simonmeaden/footprints/Harwell/lontott LOGIC BOARD.pdf

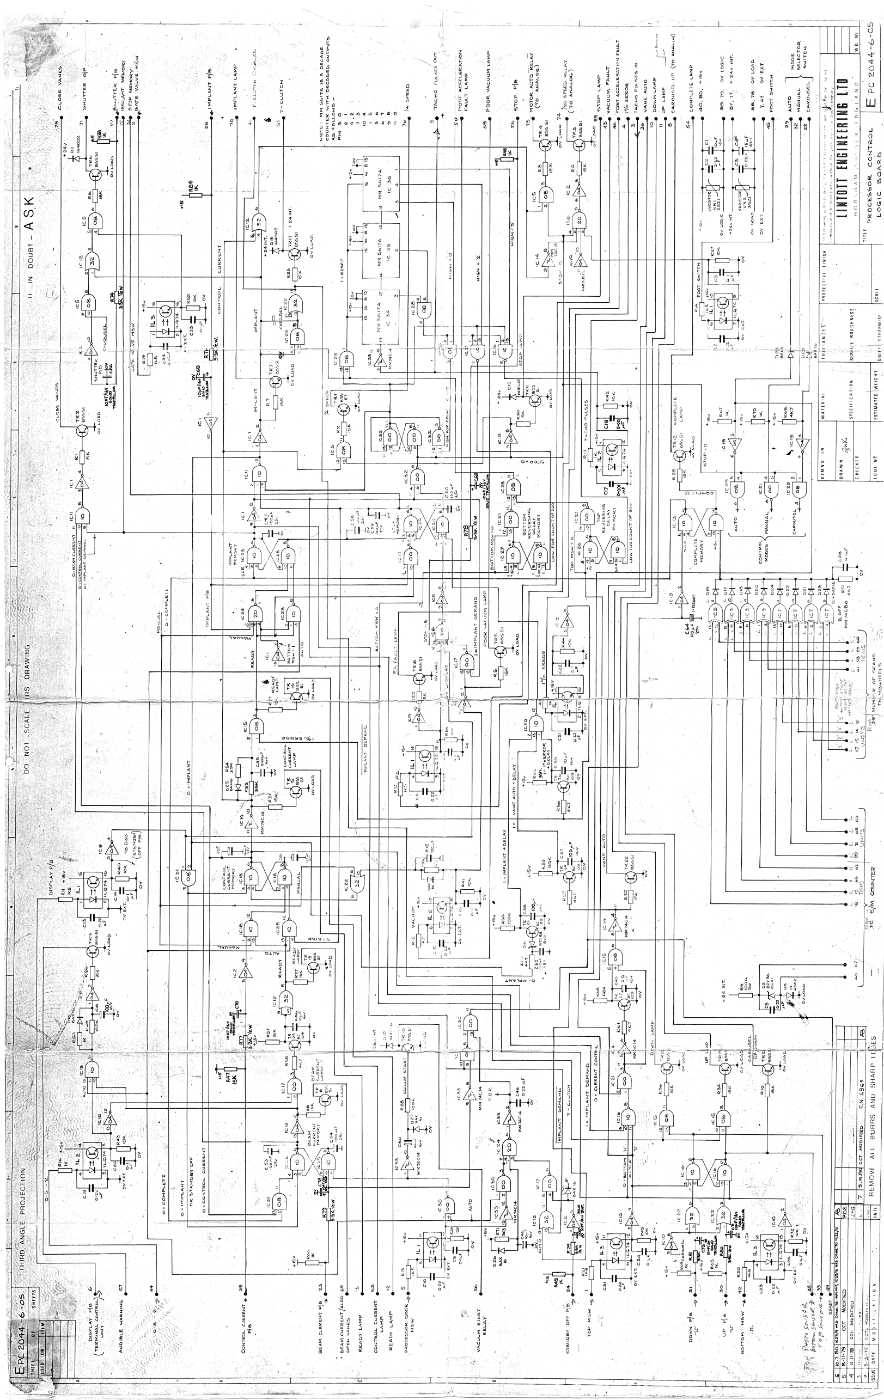
[picture p1: page 1]
