simonmeaden/footprints/Harwell/Remote control panel cables.PDF

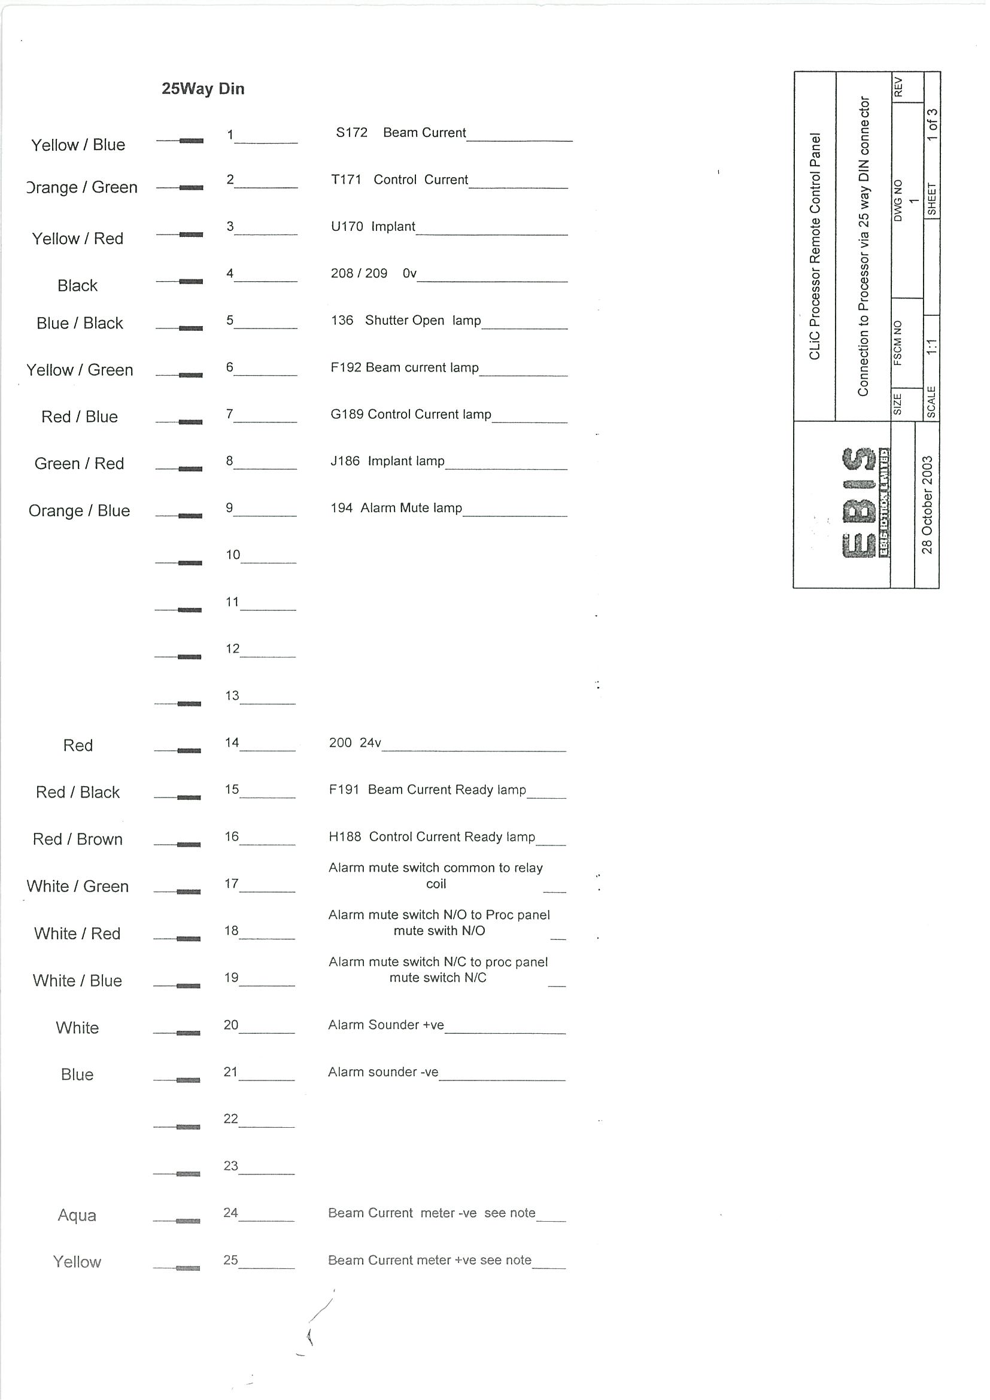
[picture p5: page 1]
