simonmeaden/footprints/Harwell/completeions.png

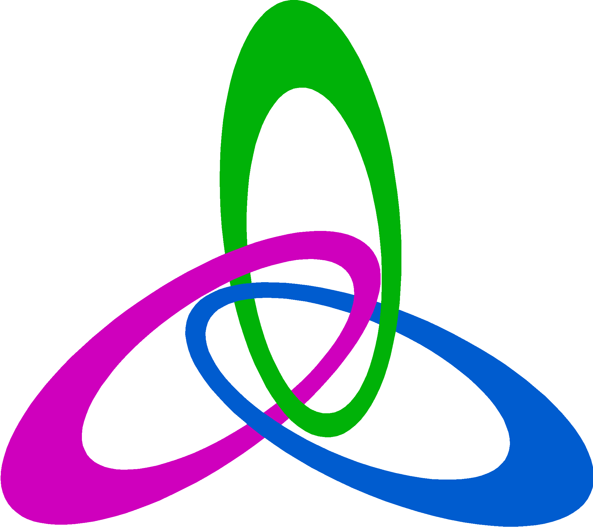
Harwell/completeions.png
