simonmeaden/footprints/Harwell/drawings/Analog_Board3.png

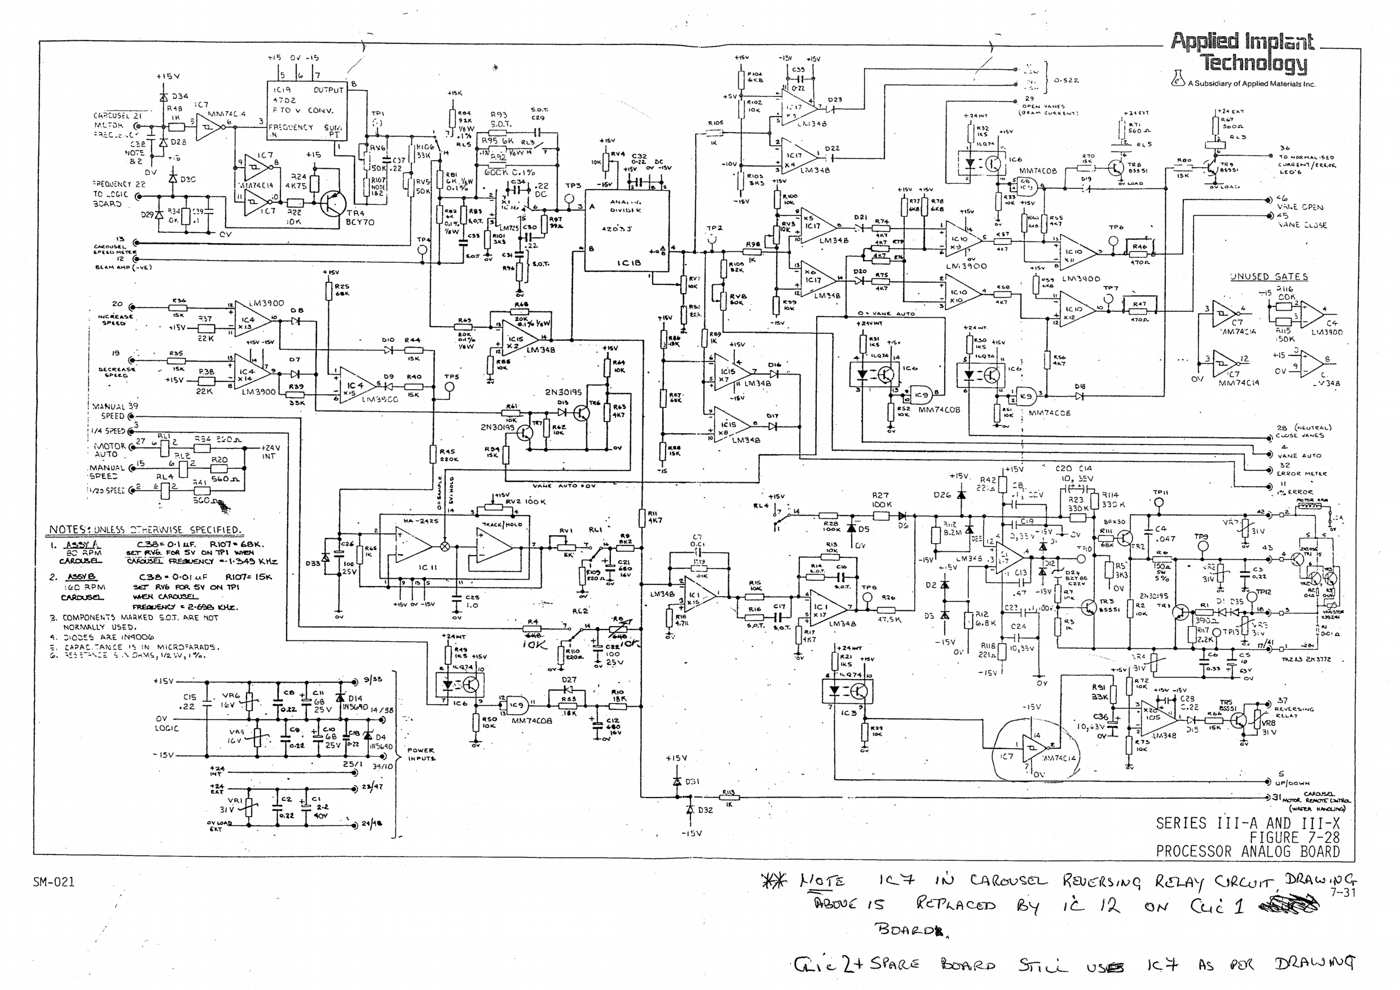
Harwell/drawings/Analog_Board3.png
