simonmeaden/footprints/Harwell/drawings/Clic Processor Remote Unit.png

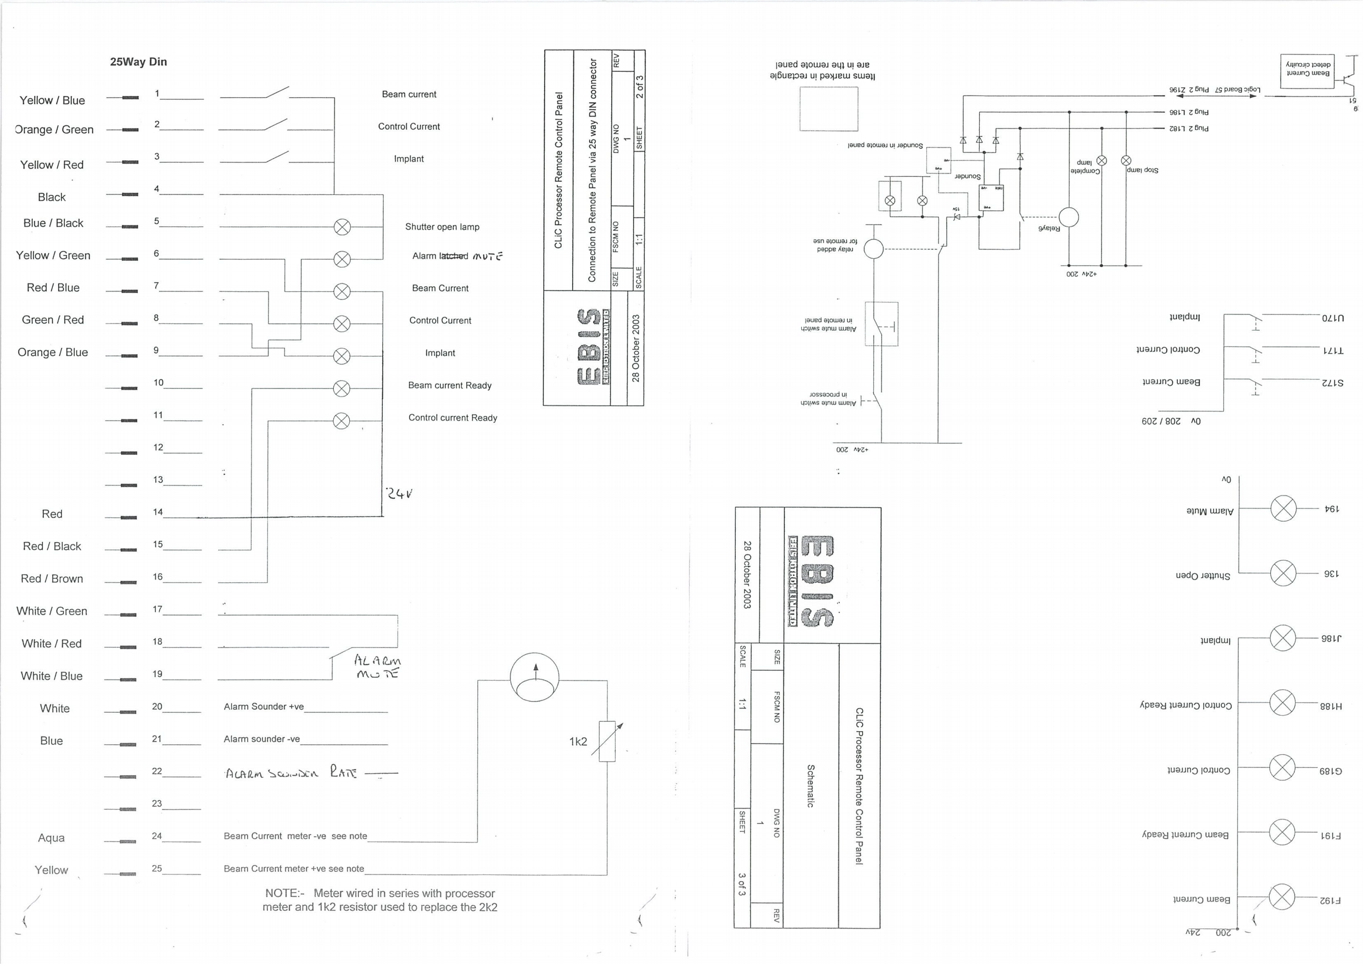
Harwell/drawings/Clic Processor Remote Unit.png
