simonmeaden/footprints/Harwell/drawings/Clutch Slip Detector.png

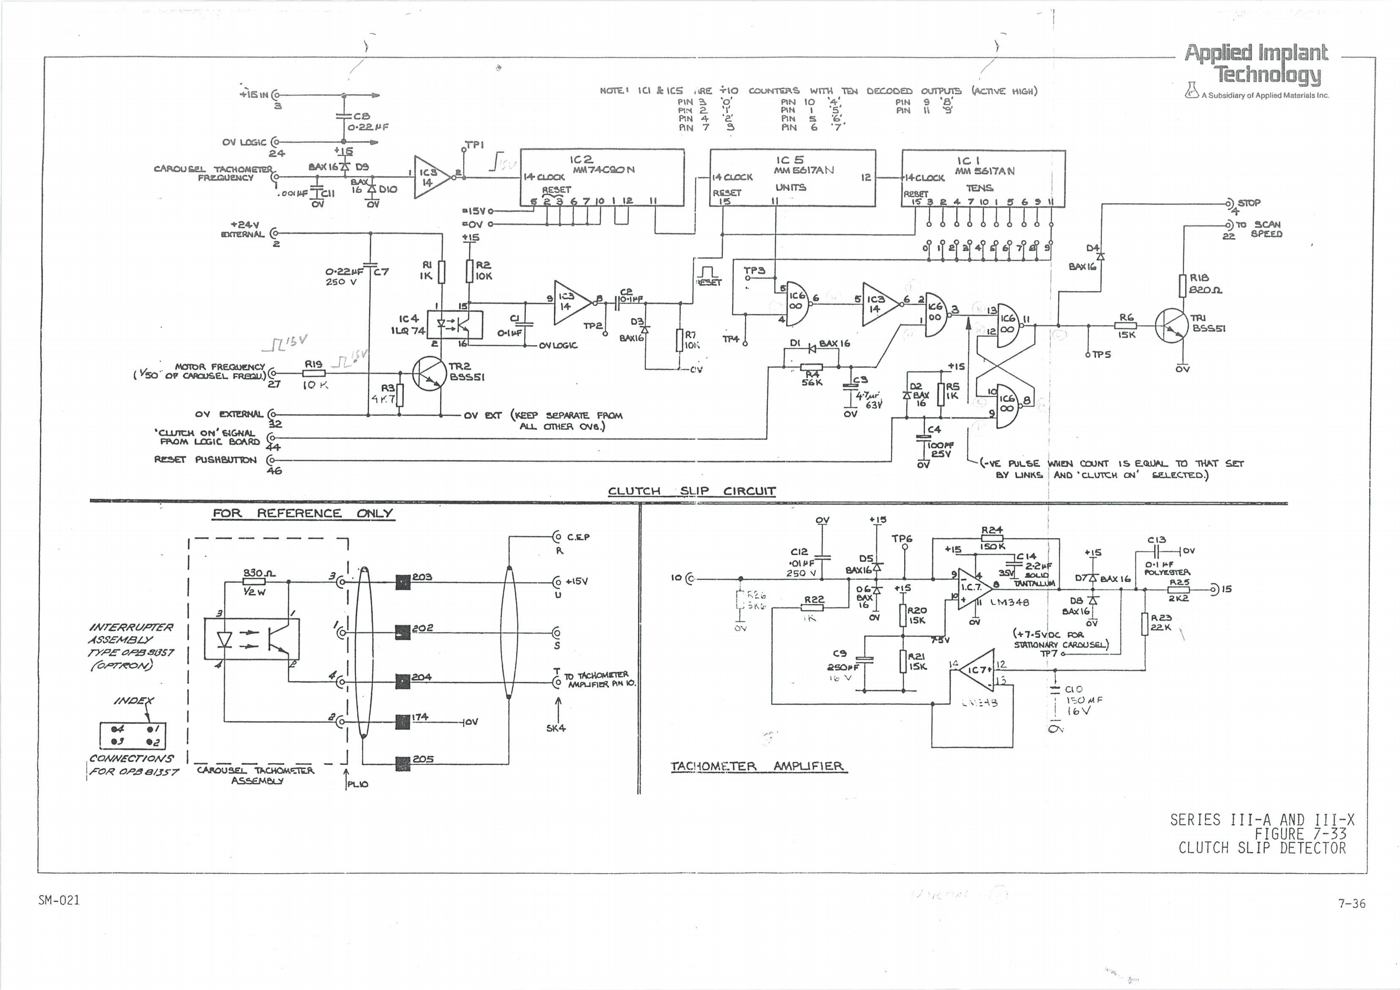
Harwell/drawings/Clutch Slip Detector.png
