simonmeaden/footprints/Harwell/drawings/Electromechanical Counter.png

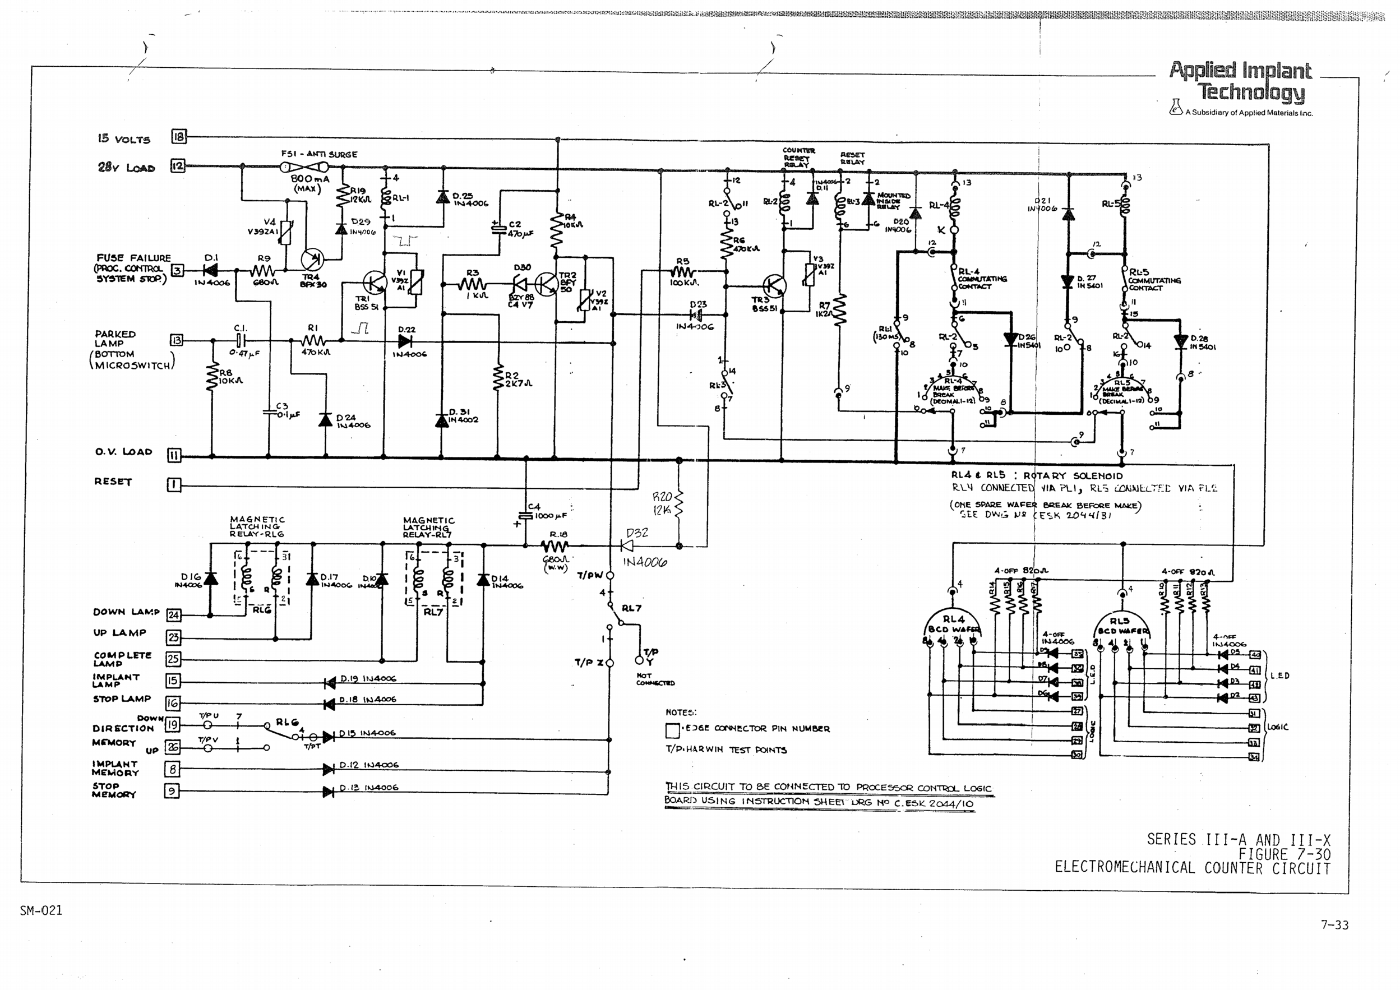
Harwell/drawings/Electromechanical Counter.png
