simonmeaden/footprints/Harwell/drawings/Left Right Drive Board.png

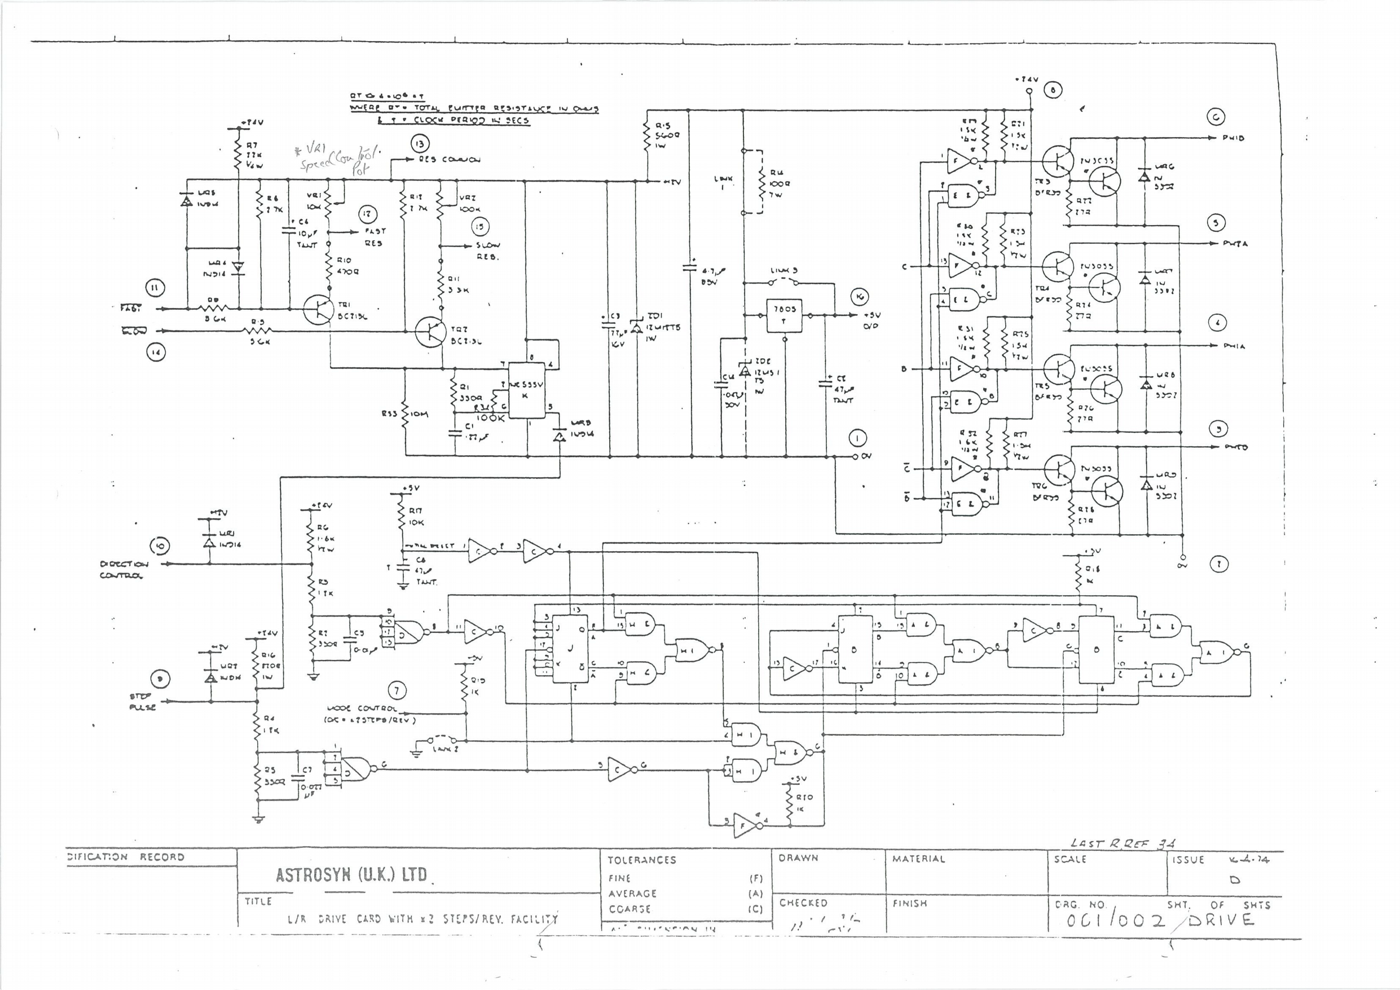
Harwell/drawings/Left Right Drive Board.png
