simonmeaden/footprints/Harwell/drawings/Outline.png

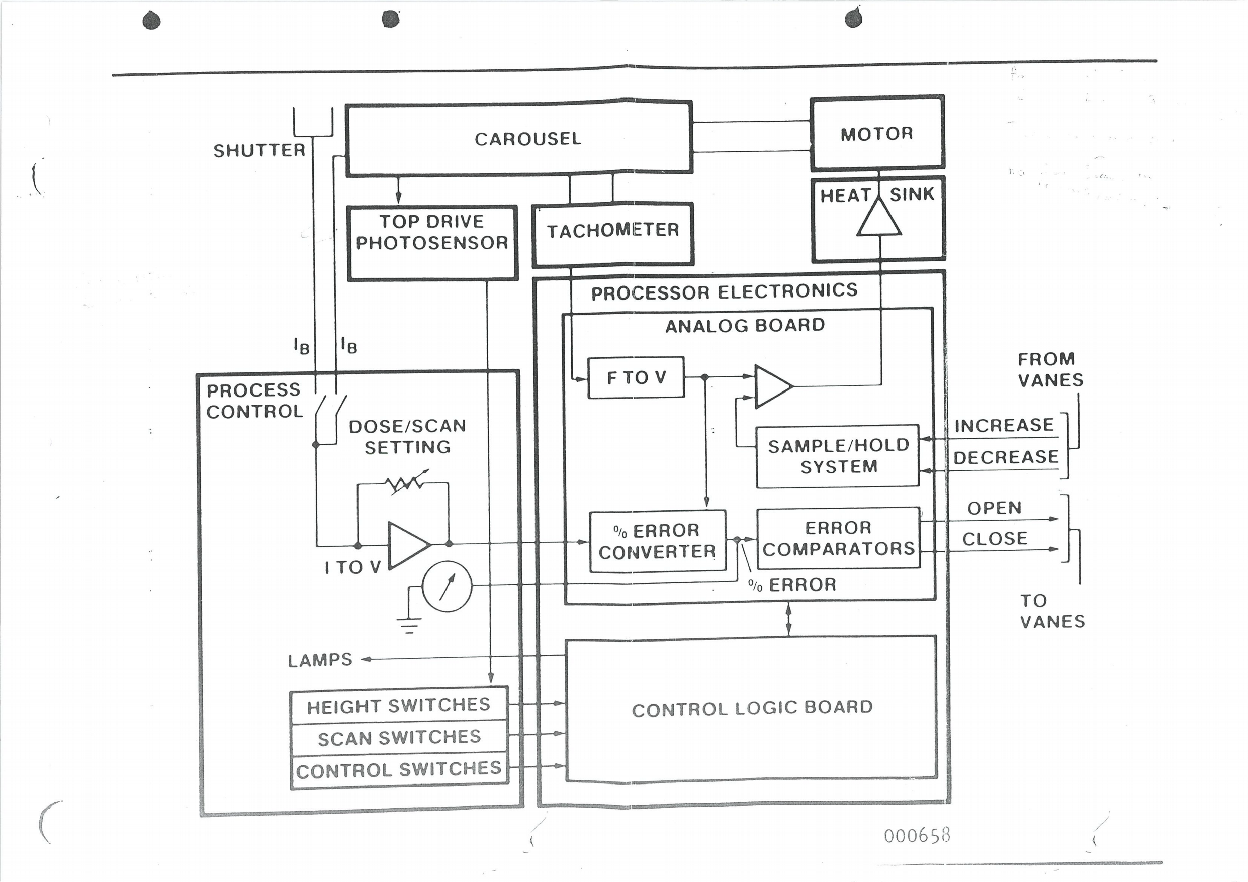
Harwell/drawings/Outline.png
