simonmeaden/footprints/Harwell/drawings/Processor Control Unit 1.png

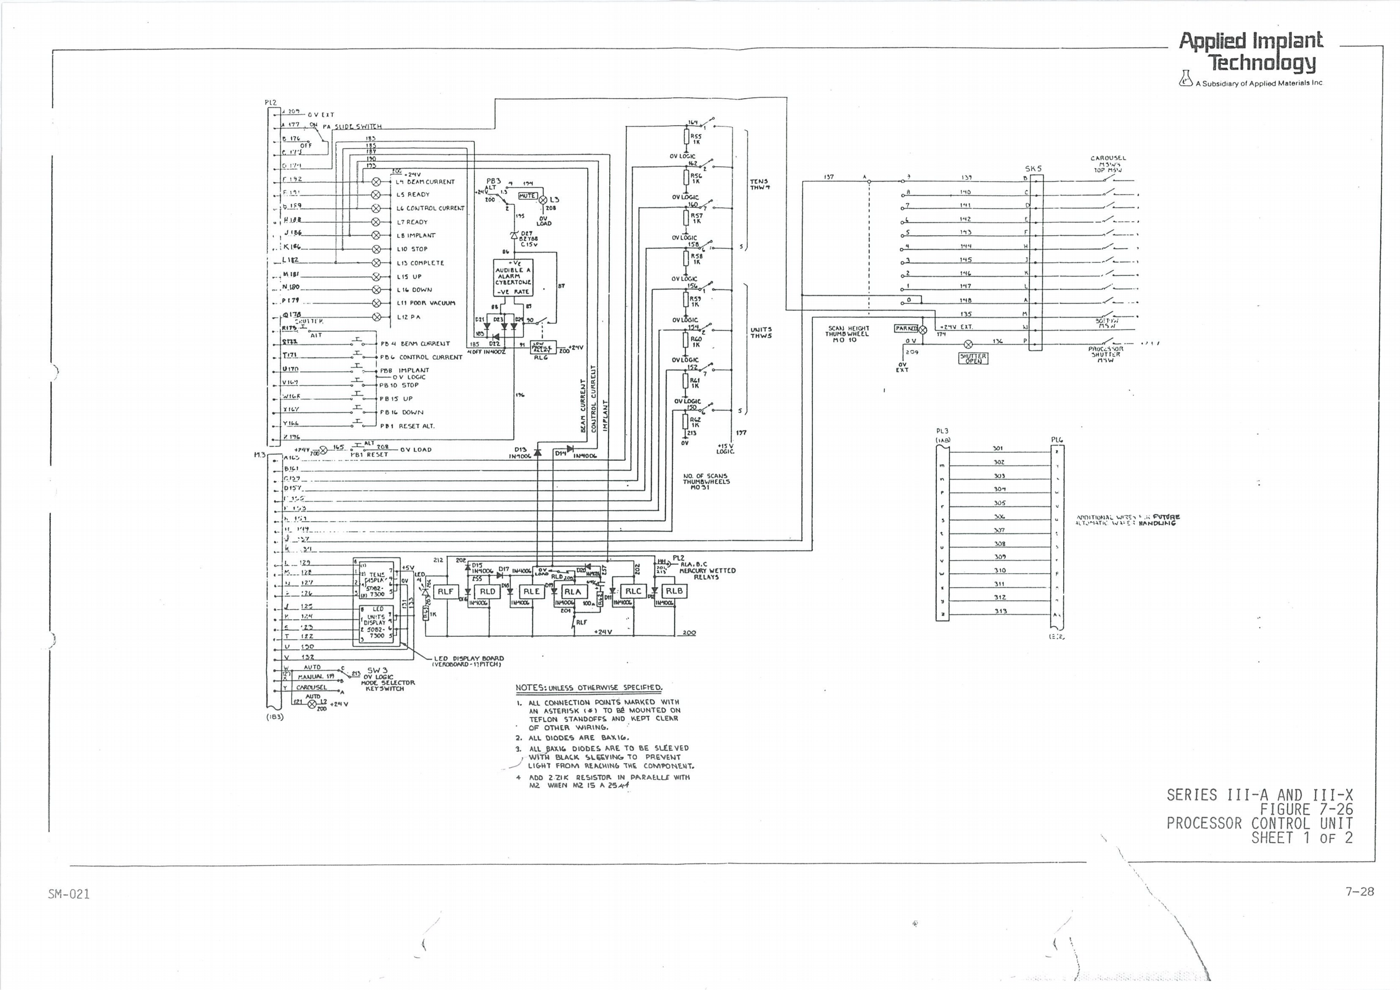
Harwell/drawings/Processor Control Unit 1.png
