simonmeaden/footprints/Harwell/drawings/Processor Control Unit 2.png

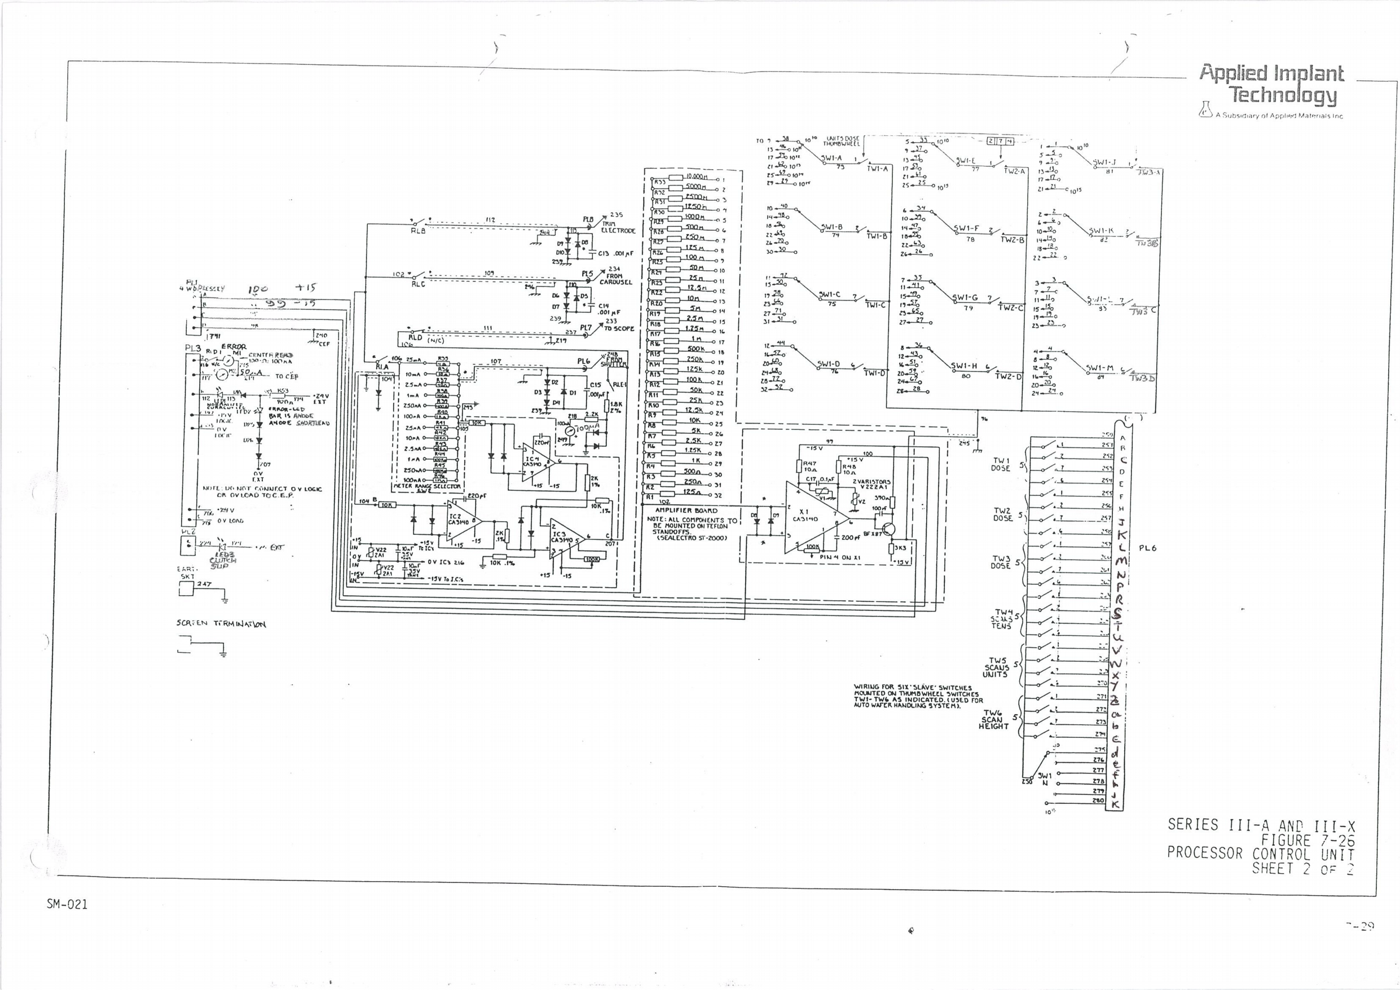
Harwell/drawings/Processor Control Unit 2.png
