simonmeaden/footprints/Harwell/drawings/Processor Control Unit 3.png

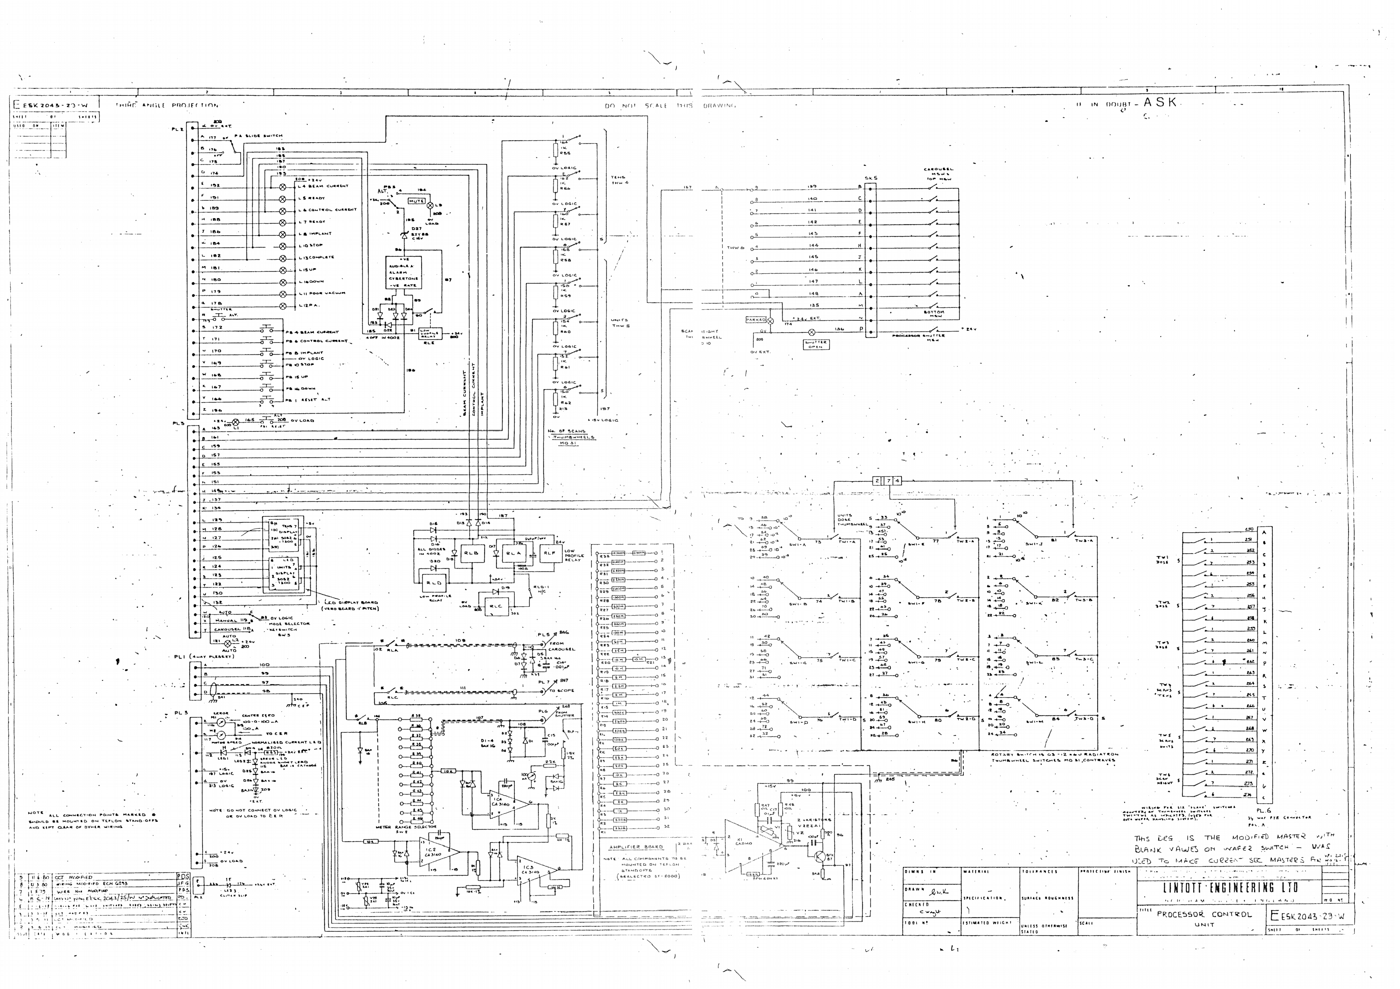
Harwell/drawings/Processor Control Unit 3.png
