simonmeaden/footprints/Harwell/drawings/Remote control panel cables.png

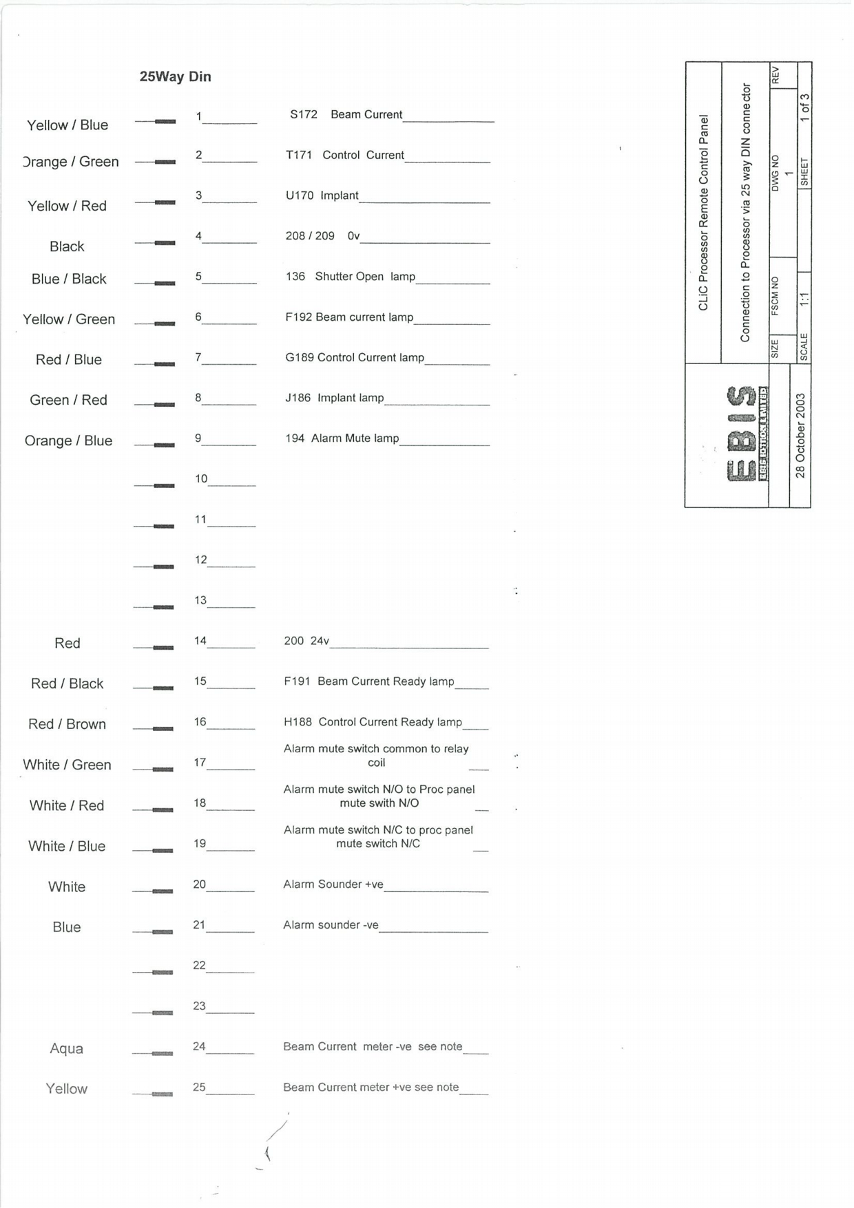
Harwell/drawings/Remote control panel cables.png
