simonmeaden/footprints/Harwell/drawings/Top Drive Phototsensor.png

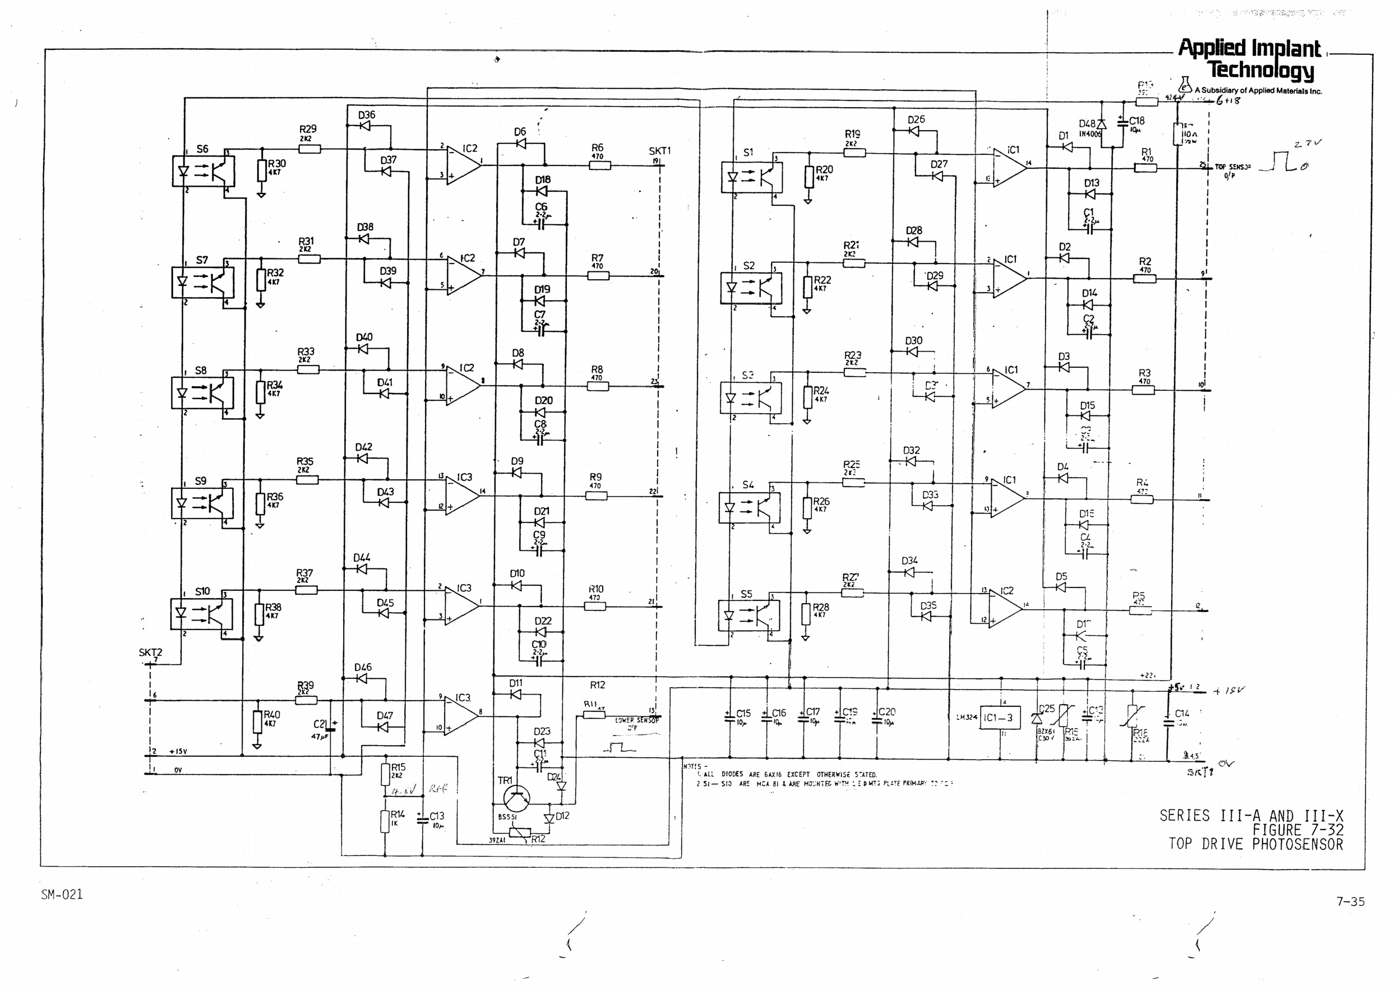
Harwell/drawings/Top Drive Phototsensor.png
