simonmeaden/footprints/Harwell/drawings/Vacuum Control.png

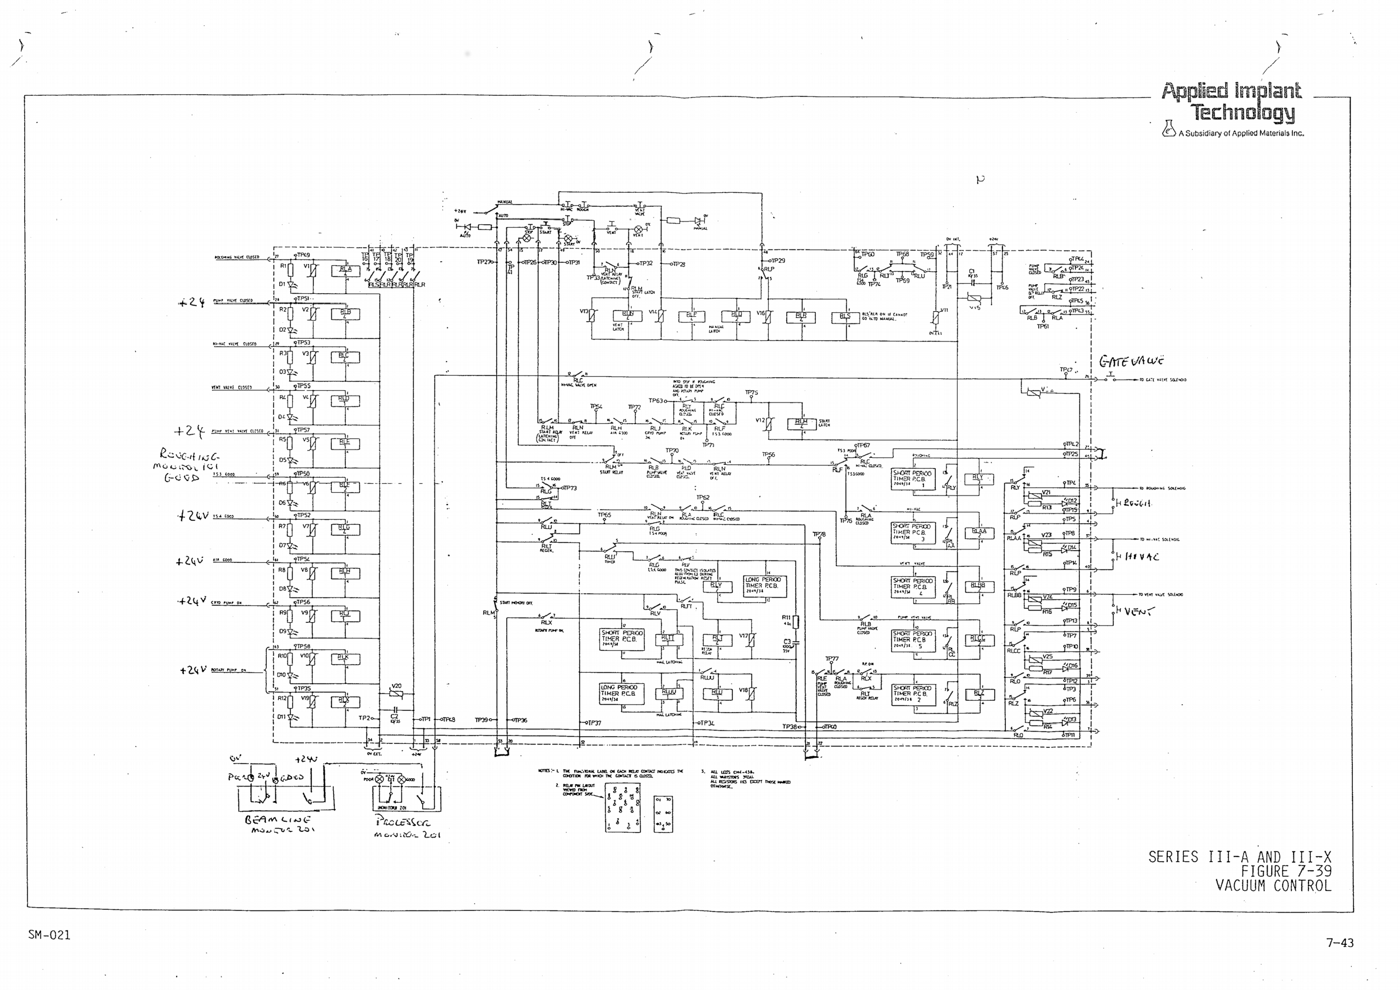
Harwell/drawings/Vacuum Control.png
