simonmeaden/footprints/Harwell/drawings/Vane Control Processor End.png

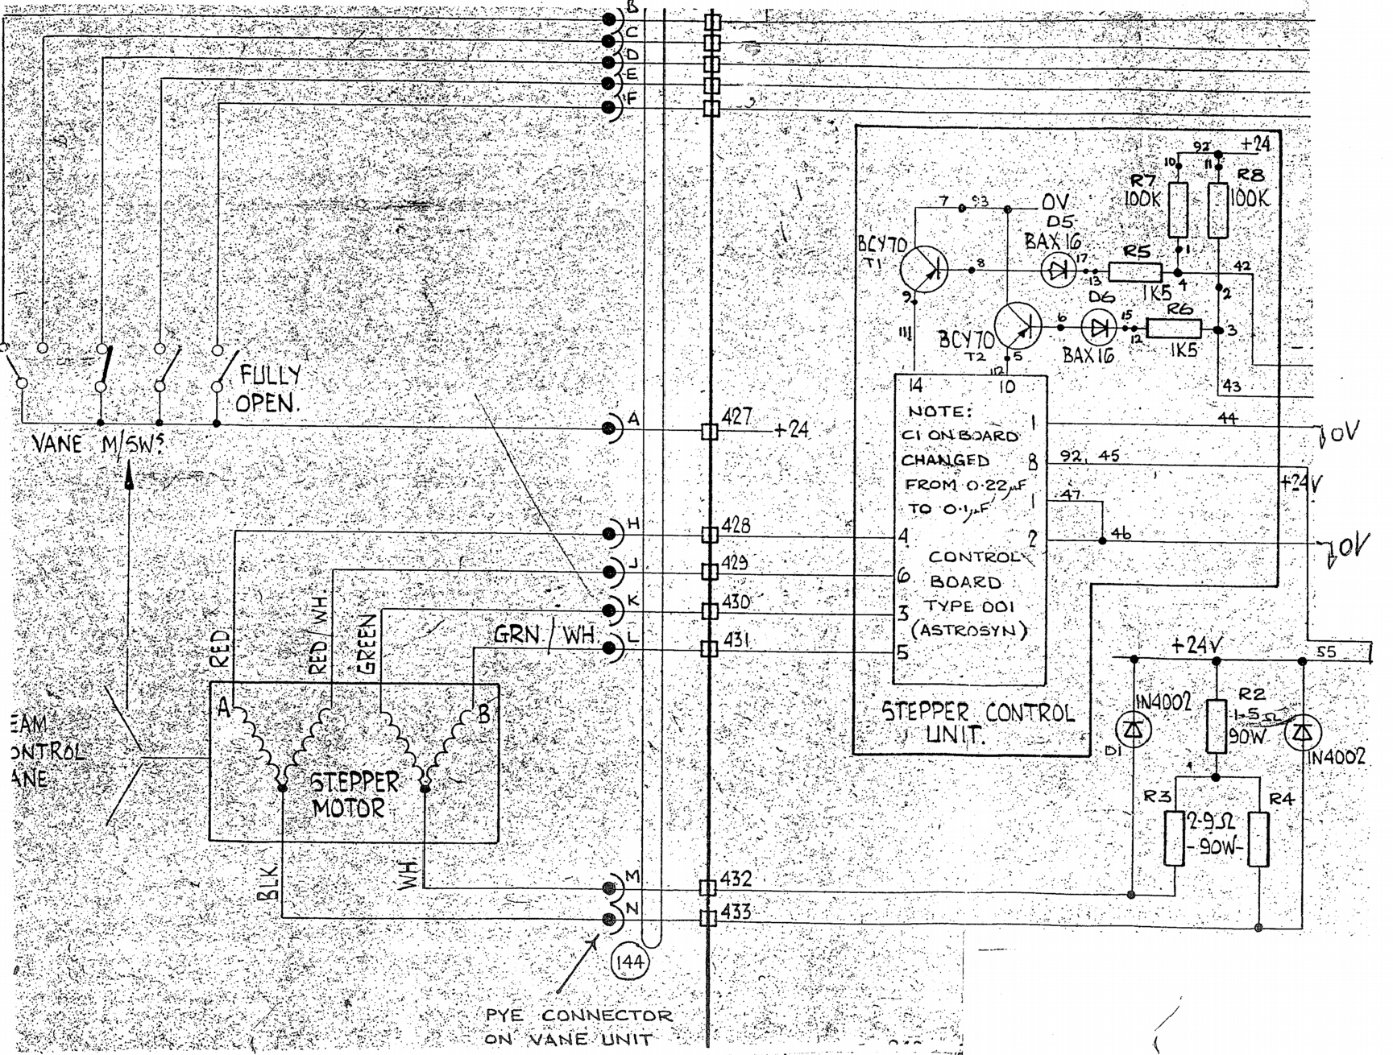
Harwell/drawings/Vane Control Processor End.png
