simonmeaden/footprints/Harwell/drawings/Vane Drive.png

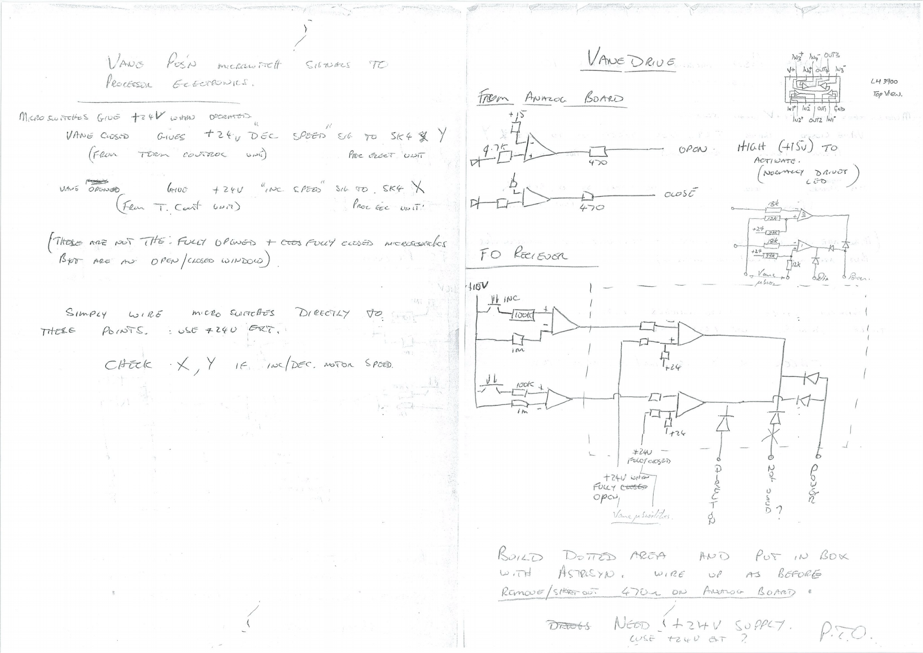
Harwell/drawings/Vane Drive.png
