simonmeaden/footprints/Harwell/drawings/Vane Stepper Unit.png

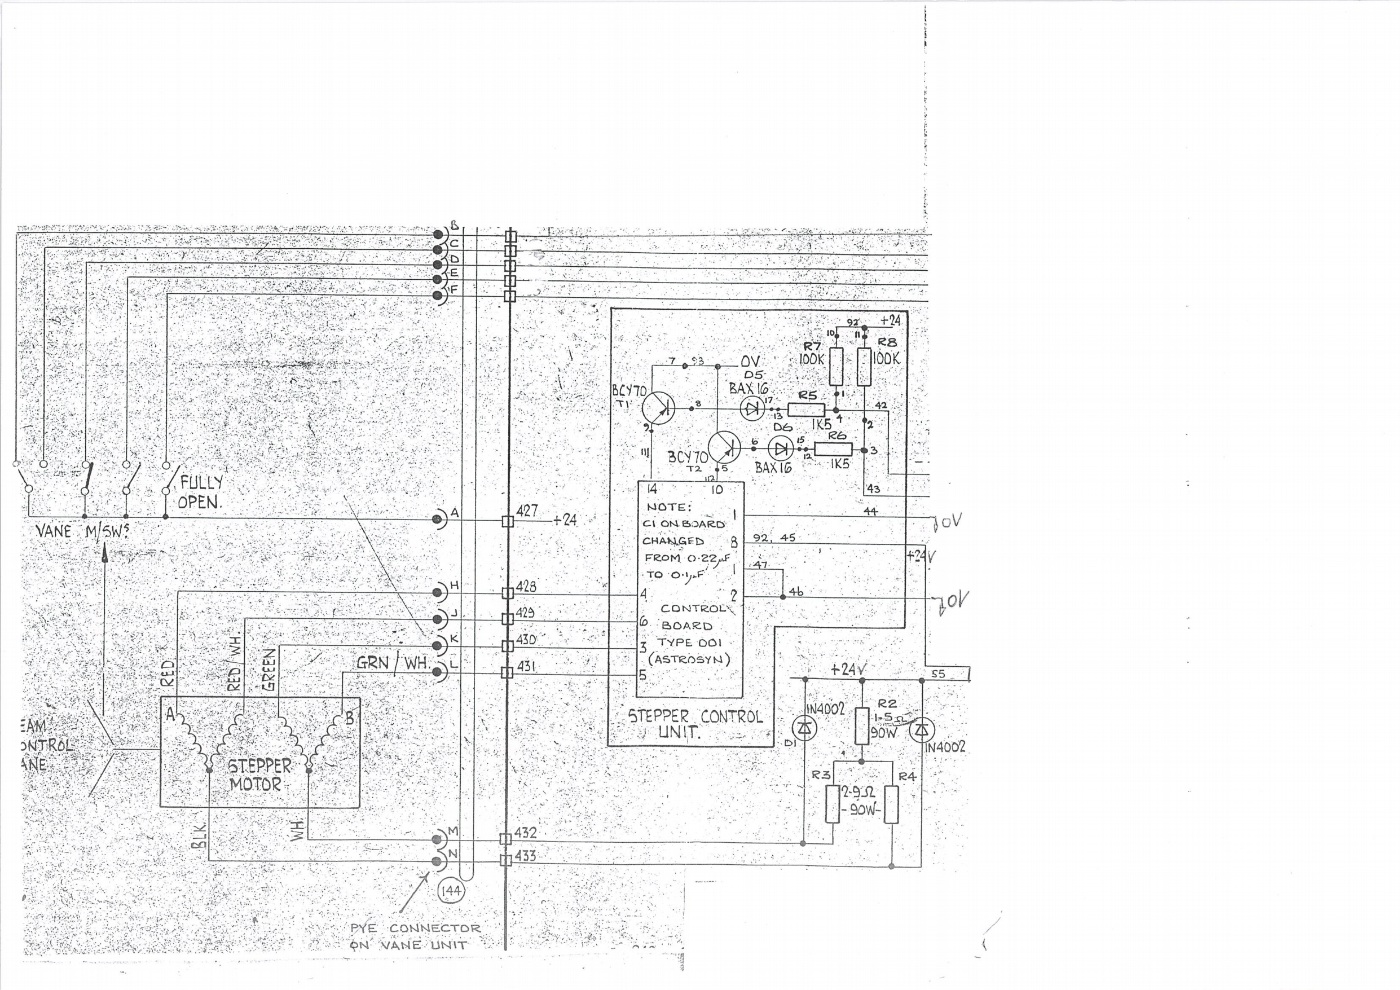
Harwell/drawings/Vane Stepper Unit.png
