simonmeaden/footprints/Harwell/parts.ods

Sheet: IC's
 |  | Part |  | Part
 | Manufacturer | Number | Supplier | Number | Description | Package
IC000001 | Microchip | SST25VF512 | Microchip | SST25VF512 | 512 Kbit SPI Serial Flash, 20MHz clock
IC000002 | Microchip | SST25VF512A | Microchip | SST25VF512A | 512 Kbit SPI Serial Flash, 33MHz clock
IC000003 | Microchip | MCP47FEB21 | Microchip | MCP47FEB21 | 12 Bit Single Channel DAC
IC000004 | Microchip | MCP47FEB22 | Microchip | MCP47FEB21 | 12 Bit Dual Channel DAC
IC000005 | Maxim | MAX743 | Farnell | 2514016 | Dual-Output Switch-Mode Regulator +5V to ±15V or ±12V
IC000006 | Intersil | CA3130 | Farnell | 1562025 | BiMOS Op Amp with MOSFET Input/ CMOS Output
IC000007 | On Semiconductor | CAT4139D | Mouser | 698-CAT4139TD-G | 22V PWM Modulated LED Driver
IC000008 | Solomon Systech | SSD1963 | In Stock | SSD1963 |  | LQFP128

Sheet: Transistors
Internal |  | Part |  | Part
Part Number | Manufacturer | Number | Supplier | Number
 |  |  | Farnell

Sheet: Diodes
Internal |  | Part |  | Part
Part Number | Manufacturer | Number | Supplier | Number
 |  |  | Farnell

Sheet: Capacitors
Internal |  | Part |  | Part
Part Number | Manufacturer | Number | Supplier | Number
 |  |  | Farnell

Sheet: Resistors
Internal |  | Part |  | Part
Part Number | Manufacturer | Number | Supplier | Number
 |  |  | Farnell

Sheet: Inductor
 |  | Part |  | Part
 | Manufacturer | Number | Supplier | Number | Description
L000001 | Wurth |  | RS Components |  | WE-TPC Series Type 3816 Shielded Wire-wound SMD Inductor with a Ferrite Core, 22 μH ±30% Wire-Wound 510mA Idc

Sheet: Connectors
 |  | Part |  | Part
 | Manufacturer | Number | Supplier | Number | Type | Pins | Polarity | Mounting | Shell | Series | Information
CON000001 | Amp-TE Connectivity | 5747250-4 | Farnell | 1653990 | D-Sub | 9 | Male | PCB | Metal Body | Amplimite HD-20
CON000002 | Cambdenboss | CTB0502/6 | Farnell | 2493624
CON000003 | Amphenol |  | Farnell
CON000004 | JST | SM02B-BHSS-1-TB(LF)(SN) | Farnell | 2399341 | Wire-to-board |  |  |  |  |  | Wire-To-Board Connector, 3.5 mm, 2 Contacts, Header, BHS
