simonmeaden/footprints/Harwell/PIC32MZ_Pin_Usage.ods

Pin | Description | Use
1 | AN23/RG15
2 | EBIA5/AN34/PMA5/RA5 | EBIA5 |  |  | Parallel Master Port || Extended Bus Interface
3 | EBID5/AN17/RPE5/PMD5/RE5 | EBID5 |  |  | Parallel Master Port || Extended Bus Interface
4 | EBID6/AN16/PMD6/RE6 | EDID6 |  |  | Parallel Master Port || Extended Bus Interface
5 | EBID7/AN15/PMD7/RE7 | EPID7 |  |  | Parallel Master Port || Extended Bus Interface
6 | EBIA6/AN22/RPC1/PMA6/RC1 | EBIA6 |  |  | Parallel Master Port || Extended Bus Interface
7 | AN35/ETXD0/RJ8
8 | AN36/ETXD1/RJ9
9 | EBIBS0/RJ12 | EBIBS0 |  |  | Parallel Master Port || Extended Bus Interface
10 | EBIBS1/RJ10 | EBIBS1 |  |  | Parallel Master Port || Extended Bus Interface
11 | EBIA12/AN21/RPC2/PMA12/RC2 | EBIA12 |  |  | Parallel Master Port || Extended Bus Interface
12 | EBIWE/AN20/RPC3/PMWR/RC3 | EBIWE |  |  | Parallel Master Port || Extended Bus Interface
13 | EBIOE/AN19/RPC4/PMRD/RC4 | EBIOE |  |  | Parallel Master Port || Extended Bus Interface
14 | AN14/C1IND/RPG6/SCK2/RG6 | RS232-RTS | RPG6 | U1RTS | RS232
15 | AN13/C1INC/RPG7/SDA4/RG7 | RS232-TX | RPG7 | U1TX | RS232
16 | AN12/C2IND/RPG8/SCL4/RG8 | RS232-RX | RPG8 | U1RX | RS232
17 | VSS | VSS |  |  | Power
18 | VDD | VDD |  |  | Power
19 | EBIA16/RK0 | EBIA16 |  |  | Parallel Master Port || Extended Bus Interface
20 | MCLR | MCLR |  |  | Reset
21 | EBIA2/AN11/C2INC/RPG9/PMA2/RG9 | EBIA2 |  |  | Parallel Master Port || Extended Bus Interface
22 | TMS/AN24/RA0
23 | AN25/RPE8/RE8 | RS232-CTS | RPG9 | U1CTS | RS232
24 | AN26/RPE9/RE9
25 | AN45/C1INA/RPB5/RB5
26 | AN4/C1INB/RB4 | AN4 |  |  | Dedicated Analogue In
27 | AN37/ERXCLK/EREFCLK/RJ11
28 | EBIA13/PMA13/RJ13 | EBIA13 |  |  | Parallel Master Port || Extended Bus Interface
29 | EBIA11/PMA11/RJ14 | EBIA11 |  |  | Parallel Master Port || Extended Bus Interface
30 | EBIA0/PMA0/RJ15 | EBIA0 |  |  | Parallel Master Port || Extended Bus Interface
31 | AN3/C2INA/RPB3/RB3 | AN3 |  |  | Dedicated Analogue In
32 | VSS |  |  |  | Power
33 | VDD |  |  |  | Power
34 | AN2/C2INB/RPB2/RB2 | AN2 |  |  | Dedicated Analogue In
35 | PGEC1/AN1/RPB1/RB1 | AN1 |  |  | Dedicated Analogue In
36 | PGED1/AN0/RPB0/RB0 | AN0 |  |  | Dedicated Analogue In
37 | PGEC2/AN46/RPB6/RB6 | PGEC2 | ICSP |  | Device Programming Interface
38 | PGED2/AN47/RPB7/RB7 | PGED2 | ICSP |  | Device Programming Interface
39 | VREF-/CVREF-/AN27/RA9
40 | VREF+/CV REF+/AN28/RA10
41 | AVDD | AVDD |  |  | Power
42 | AVSS | AVSS
43 | AN38/ETXD2/RH0 | EXT-0-INTB |  |  | External Bus Extender Interrupt
44 | AN39/ETXD3/RH1 | EXT-0-INTA |  |  | External Bus Extender Interrupt
45 | EBIRP/RH2 | EBIRP |  |  | Parallel Master Port || Extended Bus Interface
46 | RH3 | EXT-1-INTA |  |  | External Bus Extender Interrupt
47 | EBIA10/AN48/RPB8/PMA10/RBEBIA7/AN49/RPB9/PMA7/RB9 | EBIA10 |  |  | Parallel Master Port || Extended Bus Interface
48 | EBIA7/AN49/RPB9/PMA7/RB9 | EBIA7 |  |  | Parallel Master Port || Extended Bus Interface
49 | CV REFOUT/AN5/RPB10/RB10 | AN5
50 | AN6/RB11 | AN6
51 | EBIA1/PMA1/RK1 | EBIA1 |  |  | Parallel Master Port || Extended Bus Interface
52 | EBIA3/PMA3/RK2 | EBIA3 |  |  | Parallel Master Port || Extended Bus Interface
53 | EBIA17/RK3 | EBIA17 |  |  | Extended Bus Interface
54 | VSS | VSS
55 | VDD | VDD
56 | TCK/AN29/RA1 | EXT-1-INTB |  |  | External Bus Extender Interrupt
57 | TDI/AN30/RPF13/SCK5/RF13
58 | TDO/AN31/RPF12/RF12
59 | AN7/RB12 | AN7
60 | AN8/RB13 | EXT-2-INTA |  |  | External Bus Extender Interrupt
61 | AN9/RPB14/SCK3/RB14 | 485TX | RPB14 | U2TX | RS485
62 | AN10/RPB15/OCFB/RB15 | 485RX | RPB15 | U2RX | RS485
63 | VSS | VSS
64 | VDD | VDD
65 | AN40/ERXERR/RH4 | EXT-3-INTB |  |  | External Bus Extender Interrupt
66 | AN41/ERXD1/RH5 | EXT-3-INTA |  |  | External Bus Extender Interrupt
67 | AN42/ERXD2/RH6 | EXT-2-INTB |  |  | External Bus Extender Interrupt
68 | EBIA4/PMA4/RH7 | EBIA4 |  |  | Parallel Master Port || Extended Bus Interface
69 | AN32/RPD14/RD14 | EXT-4-INTB |  |  | External Bus Extender Interrupt
70 | AN33/RPD15/SCK6/RD15 | EXT-4-INTA |  |  | External Bus Extender Interrupt
71 | OSC1/CLKI/RC12
72 | OSC2/CLKO/RC15
73 | V BUS | VBUS
74 | VUSB3V3 | VUSB3V3
75 | VSS | VSS
76 | D- | D- |  |  | USB
77 | D+ | D+ |  |  | USB
78 | RPF3/USBID/RF3
79 | SDA3/RPF2/RF2
80 | SCL3/RPF8/RF8
81 | ERXD0/RH8
82 | ERXD3/RH9
83 | ECOL/RH10
84 | EBIRDY2/RH11 | EBIRDY2 |  |  | Parallel Master Port || Extended Bus Interface
85 | SCL2/RA2
86 | EBIRDY1/SDA2/RA3 | EBIRDY1 |  |  | Parallel Master Port || Extended Bus Interface
87 | EBIA14/PMCS1/PMA14/RA4 | EBIA14 |  |  | Parallel Master Port || Extended Bus Interface
88 | VDD | VDD
89 | VSS | VSS
90 | EBIA9/RPF4/SDA5/PMA9/RF4 | EBIA9 |  |  | Parallel Master Port || Extended Bus Interface
91 | EBIA8/RPF5/SCL5/PMA8/RF5 | EBIA8 |  |  | Parallel Master Port || Extended Bus Interface
92 | EBIA18/RK4 | EBIA18 |  |  | Extended Bus Interface
93 | EBIA19/RK5 | EBIA19 |  |  | Extended Bus Interface
94 | EBIA20/RK6 | EBIA20 |  |  | Extended Bus Interface
95 | RPA14/SCL1/RA14
96 | RPA15/SDA1/RA15
97 | EBIA15/RPD9/PMCS2/PMA15/RD9 | EBIA15 |  |  | Parallel Master Port || Extended Bus Interface
98 | RPD10/SCK4/RD10 | C1TX | RPD10 | CAN TX | CAN
99 | EMDC/RPD11/RD11 | C1RX | RPD11 | CAN RX | CAN
100 | ECRS/RH12
101 | ERXDV/ECRSDV/RH13
102 | RH14
103 | EBIA23/RH15 | EBIA23 |  |  | Extended Bus Interface
104 | RPD0/RTCC/INT0/RD0
105 | SOSCI/RPC13/RC13
106 | SOSCO/RPC14/T1CK/RC14
107 | VDD | VDD
108 | VSS | VSS
109 | RPD1/SCK1/RD1 | SCK1 |  | SPI
110 | EBID14/RPD2/PMD14/RD2 | EBID14 |  |  | Parallel Master Port || Extended Bus Interface
111 | EBID15/RPD3/PMD15/RD3 | EBID15 |  |  | Parallel Master Port || Extended Bus Interface
112 | EBID12/RPD12/PMD12/RD12 | EBID12 |  |  | Parallel Master Port || Extended Bus Interface
113 | EBID13/PMD13/RD13 | EBID13 |  |  | Parallel Master Port || Extended Bus Interface
114 | ETXERR/RJ0
115 | EMDIO/RJ1
116 | EBIRDY3/RJ2 | EBIRDY3 |  |  | Parallel Master Port || Extended Bus Interface
117 | EBIA22/RJ3 | EBIA22 |  |  | Extended Bus Interface
118 | SQICS0/RPD4/RD4 | SS1 | RPD4 | SPI | SPI
119 | SQICS1/RPD5/RD5
120 | ETXEN/RPD6/RD6 | SDI1 | RPD6 | SPI | SPI
121 | ETXCLK/RPD7/RD7 | SDO1 | RPD7 | SPI | SPI
122 | VDD | VDD
123 | VSS | VSS
124 | EBID11/RPF0/PMD11/RF0 | EBID11 |  |  | Parallel Master Port || Extended Bus Interface
125 | EBID10/RPF1/PMD10/RF1 | EBID10 |  |  | Parallel Master Port || Extended Bus Interface
126 | EBIA21/RK7 | EBIA21 |  |  | Extended Bus Interface
127 | EBID9/RPG1/PMD9/RG1 | EBID9 |  |  | Parallel Master Port || Extended Bus Interface
128 | EBID8/RPG0/PMD8/RG0 | EBID8 |  |  | Parallel Master Port || Extended Bus Interface
129 | TRCLK/SQICLK/RA6
130 | TRD3/SQID3/RA7
131 | EBICS0/RJ4 | EBICS0 |  |  | Parallel Master Port || Extended Bus Interface
132 | EBICS1/RJ5 | EBICS1 |  |  | Parallel Master Port || Extended Bus Interface
133 | EBICS2/RJ6 | EBICS2 |  |  | Parallel Master Port || Extended Bus Interface
134 | EBICS3/RJ7 | EBICS3 |  |  | Parallel Master Port || Extended Bus Interface
135 | EBID0/PMD0/RE0 | EBID0 |  |  | Parallel Master Port || Extended Bus Interface
136 | VSS | VSS
137 | VDD | VDD
138 | EBID1/PMD1/RE1 | EBID10 |  |  | Parallel Master Port || Extended Bus Interface
139 | TRD2/SQID2/RG14
140 | TRD1/SQID1/RG12
141 | TRD0/SQID0/RG13
142 | EBID2/PMD2/RE2 | EBID2 |  |  | Parallel Master Port || Extended Bus Interface
143 | EBID3/RPE3/PMD3/RE3 | EBID3 |  |  | Parallel Master Port || Extended Bus Interface
144 | EBID4/AN18/PMD4/RE4 | EBID4 |  |  | Parallel Master Port || Extended Bus Interface
