simonmeaden/footprints/Harwell/drawings/Base Frame Wiring.png

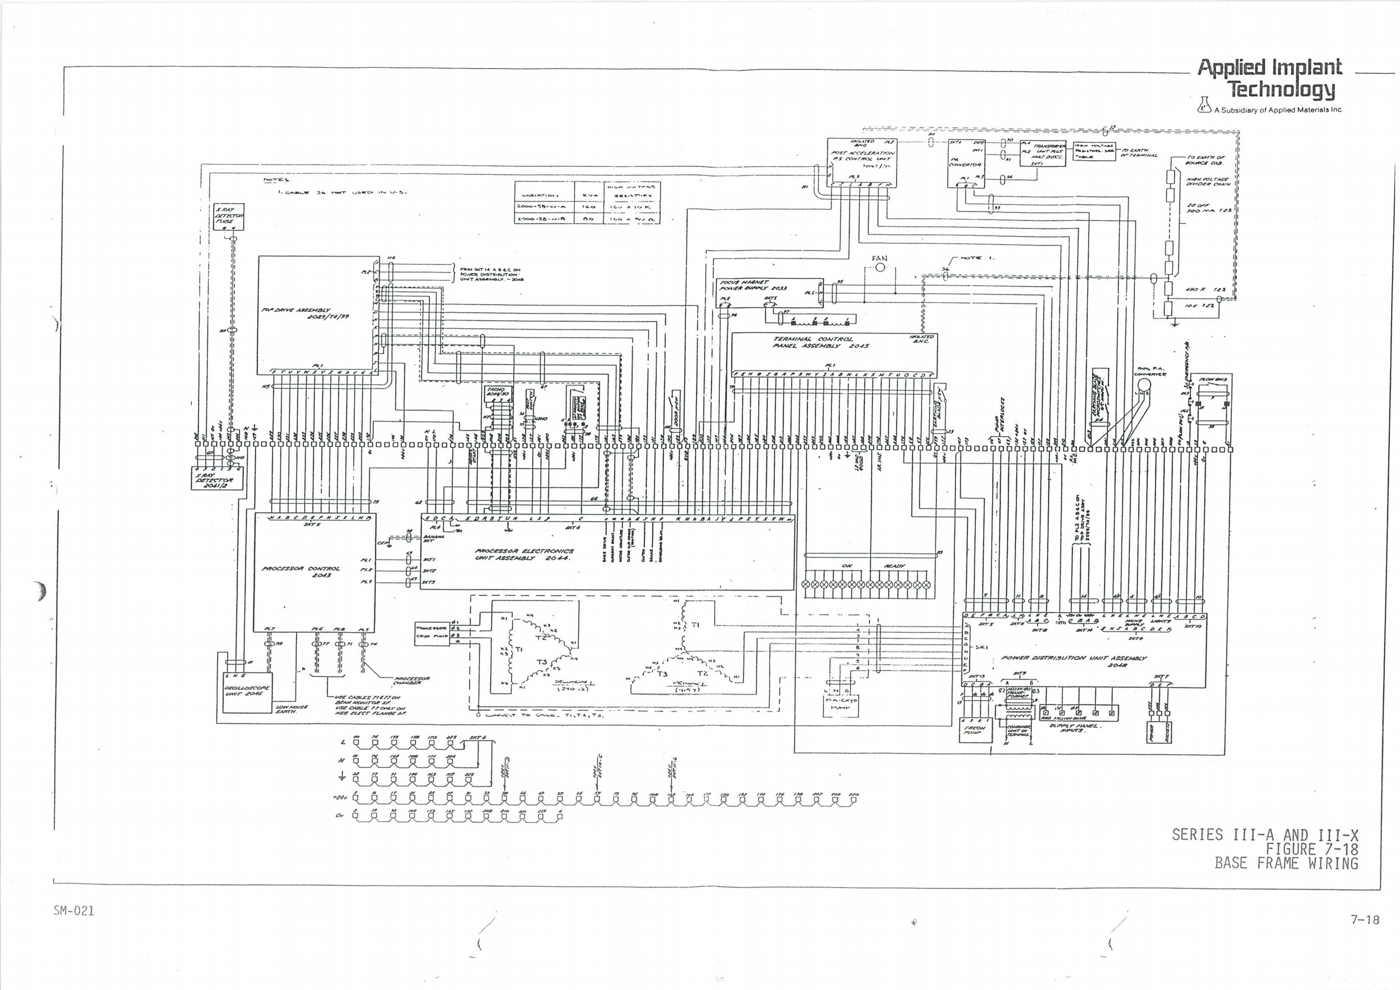
Harwell/drawings/Base Frame Wiring.png
