simonmeaden/footprints/Harwell/drawings/Processor Electronic Unit Wiring.png

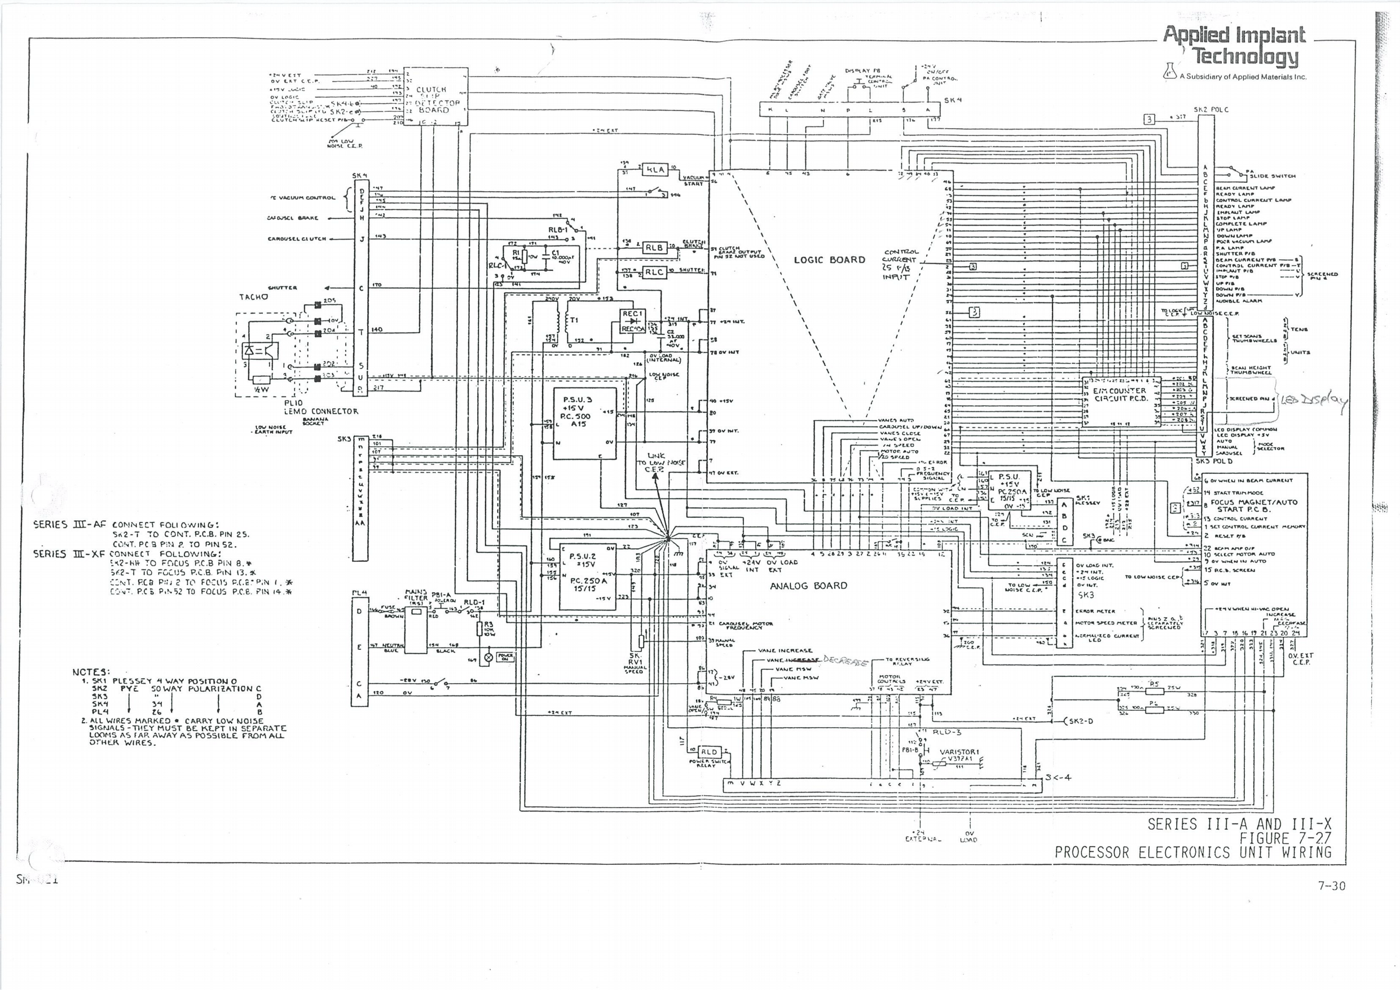
Harwell/drawings/Processor Electronic Unit Wiring.png
