simonmeaden/footprints/Harwell/drawings/Processor Top Drive Wiring.png

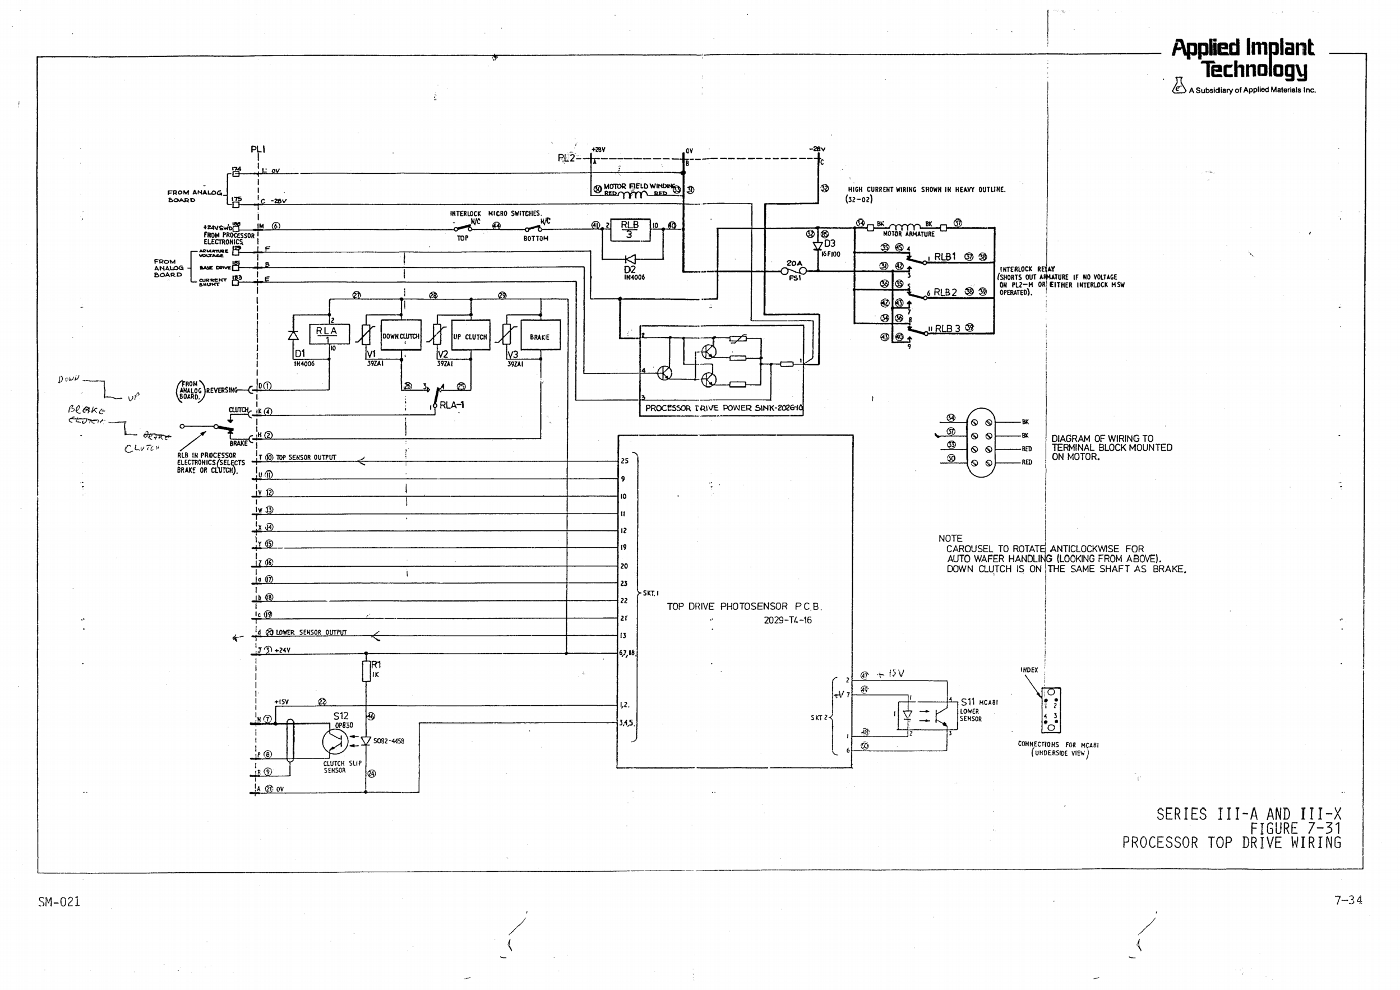
Harwell/drawings/Processor Top Drive Wiring.png
