simonmeaden/footprints/Harwell/drawings/Vacuum Control Wiring.png

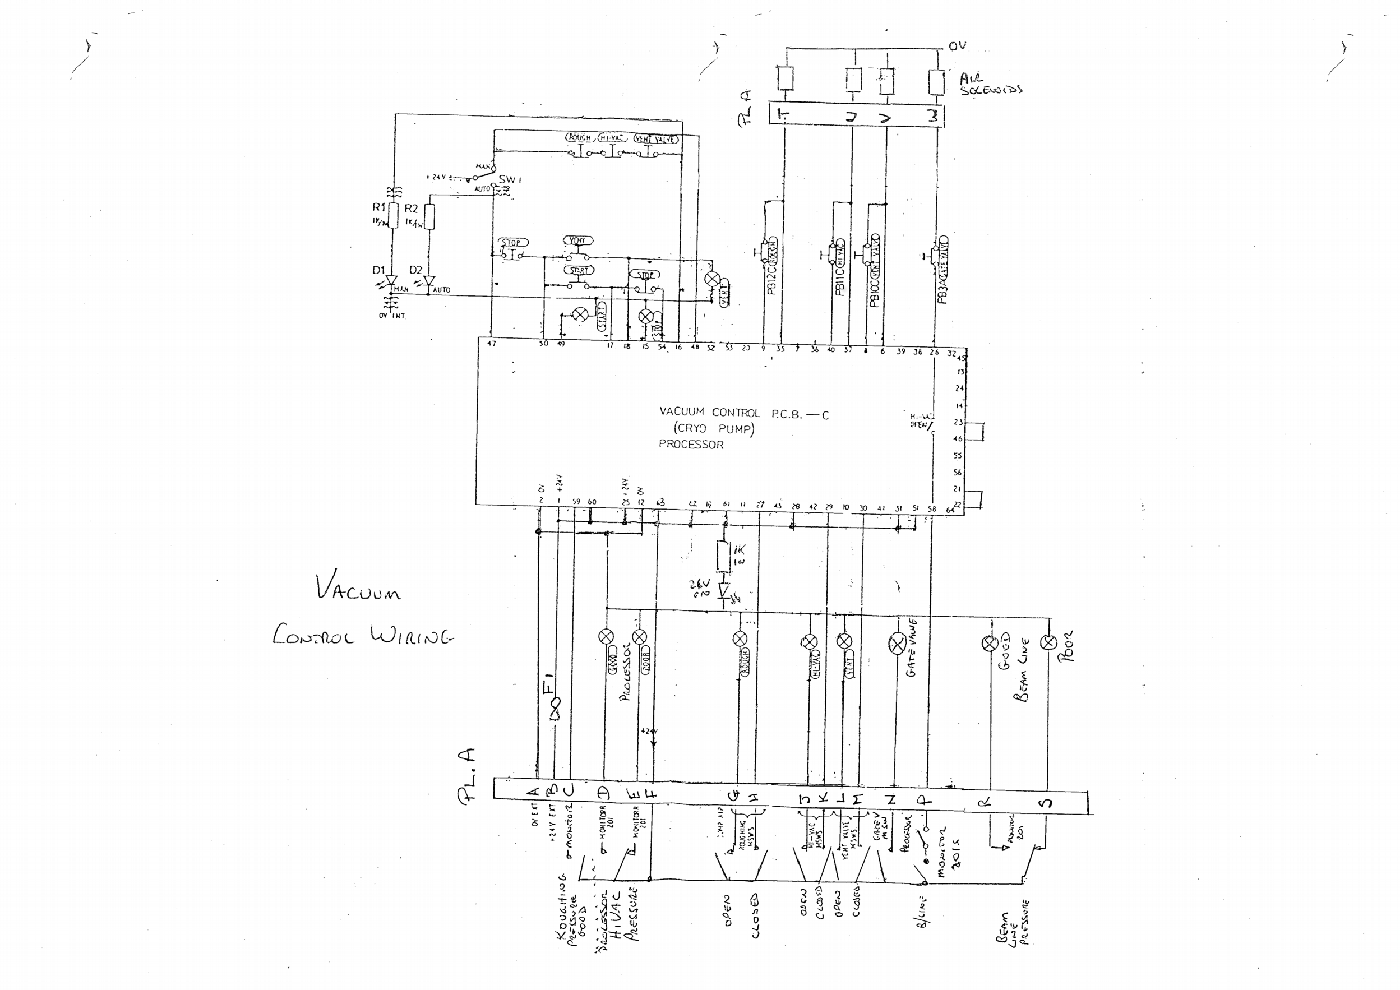
Harwell/drawings/Vacuum Control Wiring.png
