simonmeaden/footprints/Harwell/schematics/pcu/psu.kicad_pcb

## KiCad design Harwell/schematics/pcu/psu.kicad_pcb (2017-06-21)

Schematic: psu.sch, Power Supply Wiring Diagram

Parts:
C1: 2.2uF; CP_Elec_6.3x7.7
C2, C11, C13, C21: 2.2uF; C_0805
C3: 6800pF; C_0805
C4, C18, C24: 0.1uF; C_0805
C5: 3900pF; C_0805
C6, C14: 150uF; CP_Elec_6.3x7.7
C7, C9, C10, C15, C16, C23, C29: 0.01uF; C_0805
C8, C17: TBD; C_0805
C12: 22uF; C_0805
C19: 3300pF; C_0805
C20: 2200pF; C_0805
C25, C31: 100uF; CP_Tantalum_Case-X_EIA-7343-43_Reflow
C26, C36: 10uF; CP_Tantalum_Case-B_EIA-3528-21_Reflow
C27, C37: 1uF; CP_Tantalum_Case-A_EIA-3216-18_Reflow
C32: 22uF Tantalum; CP_Tantalum_Case-B_EIA-3528-21_Reflow
D1: MBR630; D_SOD-123
D2: MBR530; D_SOD-123
JP5: Jumper 5; SOLDER-JUMPER_2-WAY
L1, L2: 4uH; Inductor_Murata_3900_Series
L3, L4: 100uH; Inductor_TDK_VLCF5020_Series
L6: 22uH; Inductor_TDK__SLF_Series
M4: B240
Q1, Q6: FDS6612A
Q2, Q3, Q4, Q5: FDS6690AS
R1, R16: 15R; R_0805
R2, R3, R4, R17: 100K; R_0805
R5: 49K7; R_0805
R6: 1K8; R_0805
R7, R13: 330R; R_0805
R8, R12: 10K; R_0805
R9, R11: 18K2; R_0805
R10: 3R92; R_0805
R14: 2K7; R_0805
R15: 28K8; R_0805
R31: 20R; Potentiometer_Bourns_3362P
SKT1: CONN_01X02; CTBP9558_2AO
SKT2: LM2N_3.5_16; LM2N_16_2
TP1, TP2, TP3, TP4, TP5, TP6, TP7: TEST; Measurement_Point_Square-TH_Big
U3: MAX743; SO-16-W; Part Number IC000005
U5: CAT4139; TSOT-23-5; Part Number IC000007
U$3: TPD51020; TSSOP30

Connections:
+3V3: C14.1, C15.1, C20.2, L2.2, R15.2, SKT2.5, SKT2.6, SKT2.7, SKT2.8, TP4.1, U$3.11 (VO2)
+5V: C3.1, C6.1, C7.1, C24.1, C32.1, C36.1, JP5.3 (G3), L1.2, L3.1, L6.1, R5.1, SKT2.1, SKT2.2, SKT2.3, SKT2.4, TP2.1, U3.3 (AV+), U3.4 (V+), U3.5 (V+), U3.12 (V+), U3.13 (V+), U5.4 (~SHDN~), U5.5 (VIN), U$3.5 (VO1_VDDQ), U$3.21 (REG5_IN)
/DCIN: C1.1, C2.1, C12.1, C21.2, Q1.D, Q6.D, R2.1, R3.1, R4.1, R10.2, SKT1.1, TP1.1
/GND+12V: C31.2, D2.2 (A), SKT2.10, TP6.1, U3.9 (FB-)
/LL1: C4.1, L1.1, Q1.S, Q2.D, Q3.D, U$3.28 (LL1)
/LL2: C18.2, L2.1, Q4.D, Q5.D, Q6.S, U$3.18 (LL2)
/N$54: Q2.G, Q3.G, U$3.27 (OUT1_D)
/N$58: Q4.G, Q5.G, U$3.19 (OUT2_D)
/OUT1_U: Q1.G, R1.2
/OUT2_U: Q6.G, R16.2
/VDD+12.0: C25.1, D1.1 (K), SKT2.9, TP5.1, U3.16 (FB+)
/VDDLCD+: C37.1, M4.C, SKT2.11, TP7.1
GND: C1.2, C2.2, C6.2, C7.2, C9.1, C10.1, C11.2, C12.2, C13.1, C14.2, C15.2, C16.1, C21.1, C23.2, C24.2, C25.2, C26.2, C27.2, C29.2, C31.1, C32.2, C36.2, C37.2, JP5.1 (G1), L4.2, Q2.S, Q3.S, Q4.S, Q5.S, R8.1, R12.1, R31.2, SKT1.2, SKT2.12, SKT2.13, SKT2.14, SKT2.15, SKT2.16, TP3.1, U3.2 (AGND), U3.14 (GND), U5.2 (GND), U$3.4 (~SKIP~), U$3.7 (GND), U$3.20 (OUTGND2), U$3.26 (OUTGND1)
unnamed: C3.2, R7.1
unnamed: C4.2, U$3.30 (VBST1)
unnamed: C5.1, R5.2, R7.2, R8.2, U$3.1 (INV1)
unnamed: C5.2, R6.1
unnamed: C8.1, R9.1, U$3.25 (TRIP1)
unnamed: C9.2, U$3.3 (SSTRT1)
unnamed: C10.2, U$3.8 (REF_X)
unnamed: C8.2, C11.1, C17.2, R9.2, R10.1, R11.2, U$3.24 (VIN)
unnamed: C13.2, R17.2, U$3.22 (VREG5)
unnamed: C16.2, U$3.13 (SSTRT2)
unnamed: C17.1, R11.1, U$3.23 (TRIP2)
unnamed: C18.1, U$3.16 (VBST2)
unnamed: C19.1, R12.2, R13.1, R15.1, U$3.15 (INV2)
unnamed: C19.2, R14.1
unnamed: C20.1, R13.2
unnamed: C23.1, U3.1 (CC+)
unnamed: C26.1, U3.6 (VREF)
unnamed: C27.1, U3.7 (SS)
unnamed: C29.1, U3.8 (CC-)
unnamed: D1.2 (A), L3.2, U3.15 (LX+)
unnamed: D2.1 (K), L4.1, U3.10 (LX-)
unnamed: JP5.2 (G2), U3.11 (12/~15~)
unnamed: L6.2, M4.A, U5.1 (SW)
unnamed: R1.1, U$3.29 (OUT1_U)
unnamed: R2.2, U$3.10 (ENBL2)
unnamed: R3.2, U$3.9 (ENBL1)
unnamed: R4.2, U$3.6 (~DDR~)
unnamed: R6.2, U$3.2 (COMP1)
unnamed: R14.2, U$3.14 (COMP2)
unnamed: R16.1, U$3.17 (OUT2_U)
unnamed: R17.1, U$3.12 (PGOOD)
unnamed: R31.1, U5.3 (FB)

Notes on the sheet:
∓12V @ 125mA.Supply for DAC Buffer ampifier to avoid output Signal approaching either power rail.
Resistor R18 sets output voltage. 9.3V = 13R7
For Display LED Backlight.
Primary 5.0V & 3.3V Power supply.
DAC Buffer amp PSU
Display Backlight PSU
JP5 : 2-3 Connect for +12V 1-2 Connect for +15V

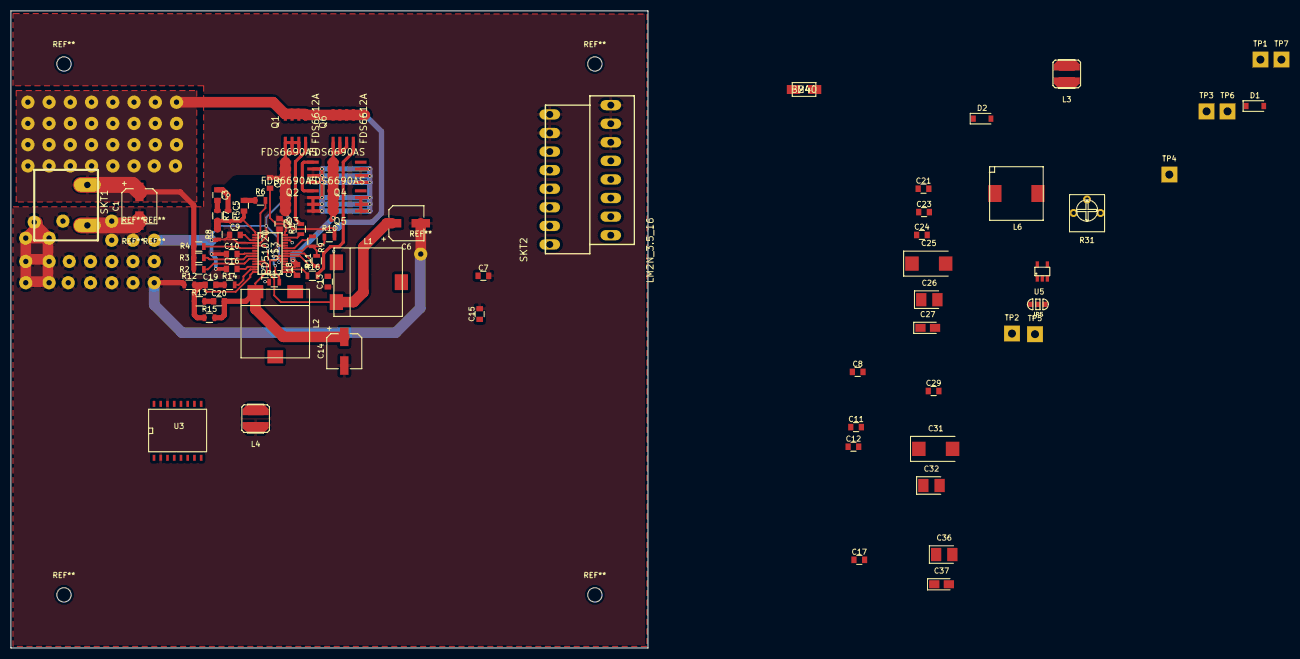
[picture p189: board psu.kicad_pcb from above]

Board: 4 copper layers, 120.0 x 120.0 mm, 76 parts (0 on the bottom side), 43 nets.
