simonmeaden/footprints/Harwell/schematics/pcu/motor_speed_controller.kicad_pcb

## KiCad design Harwell/schematics/pcu/motor_speed_controller.kicad_pcb (2017-06-21)

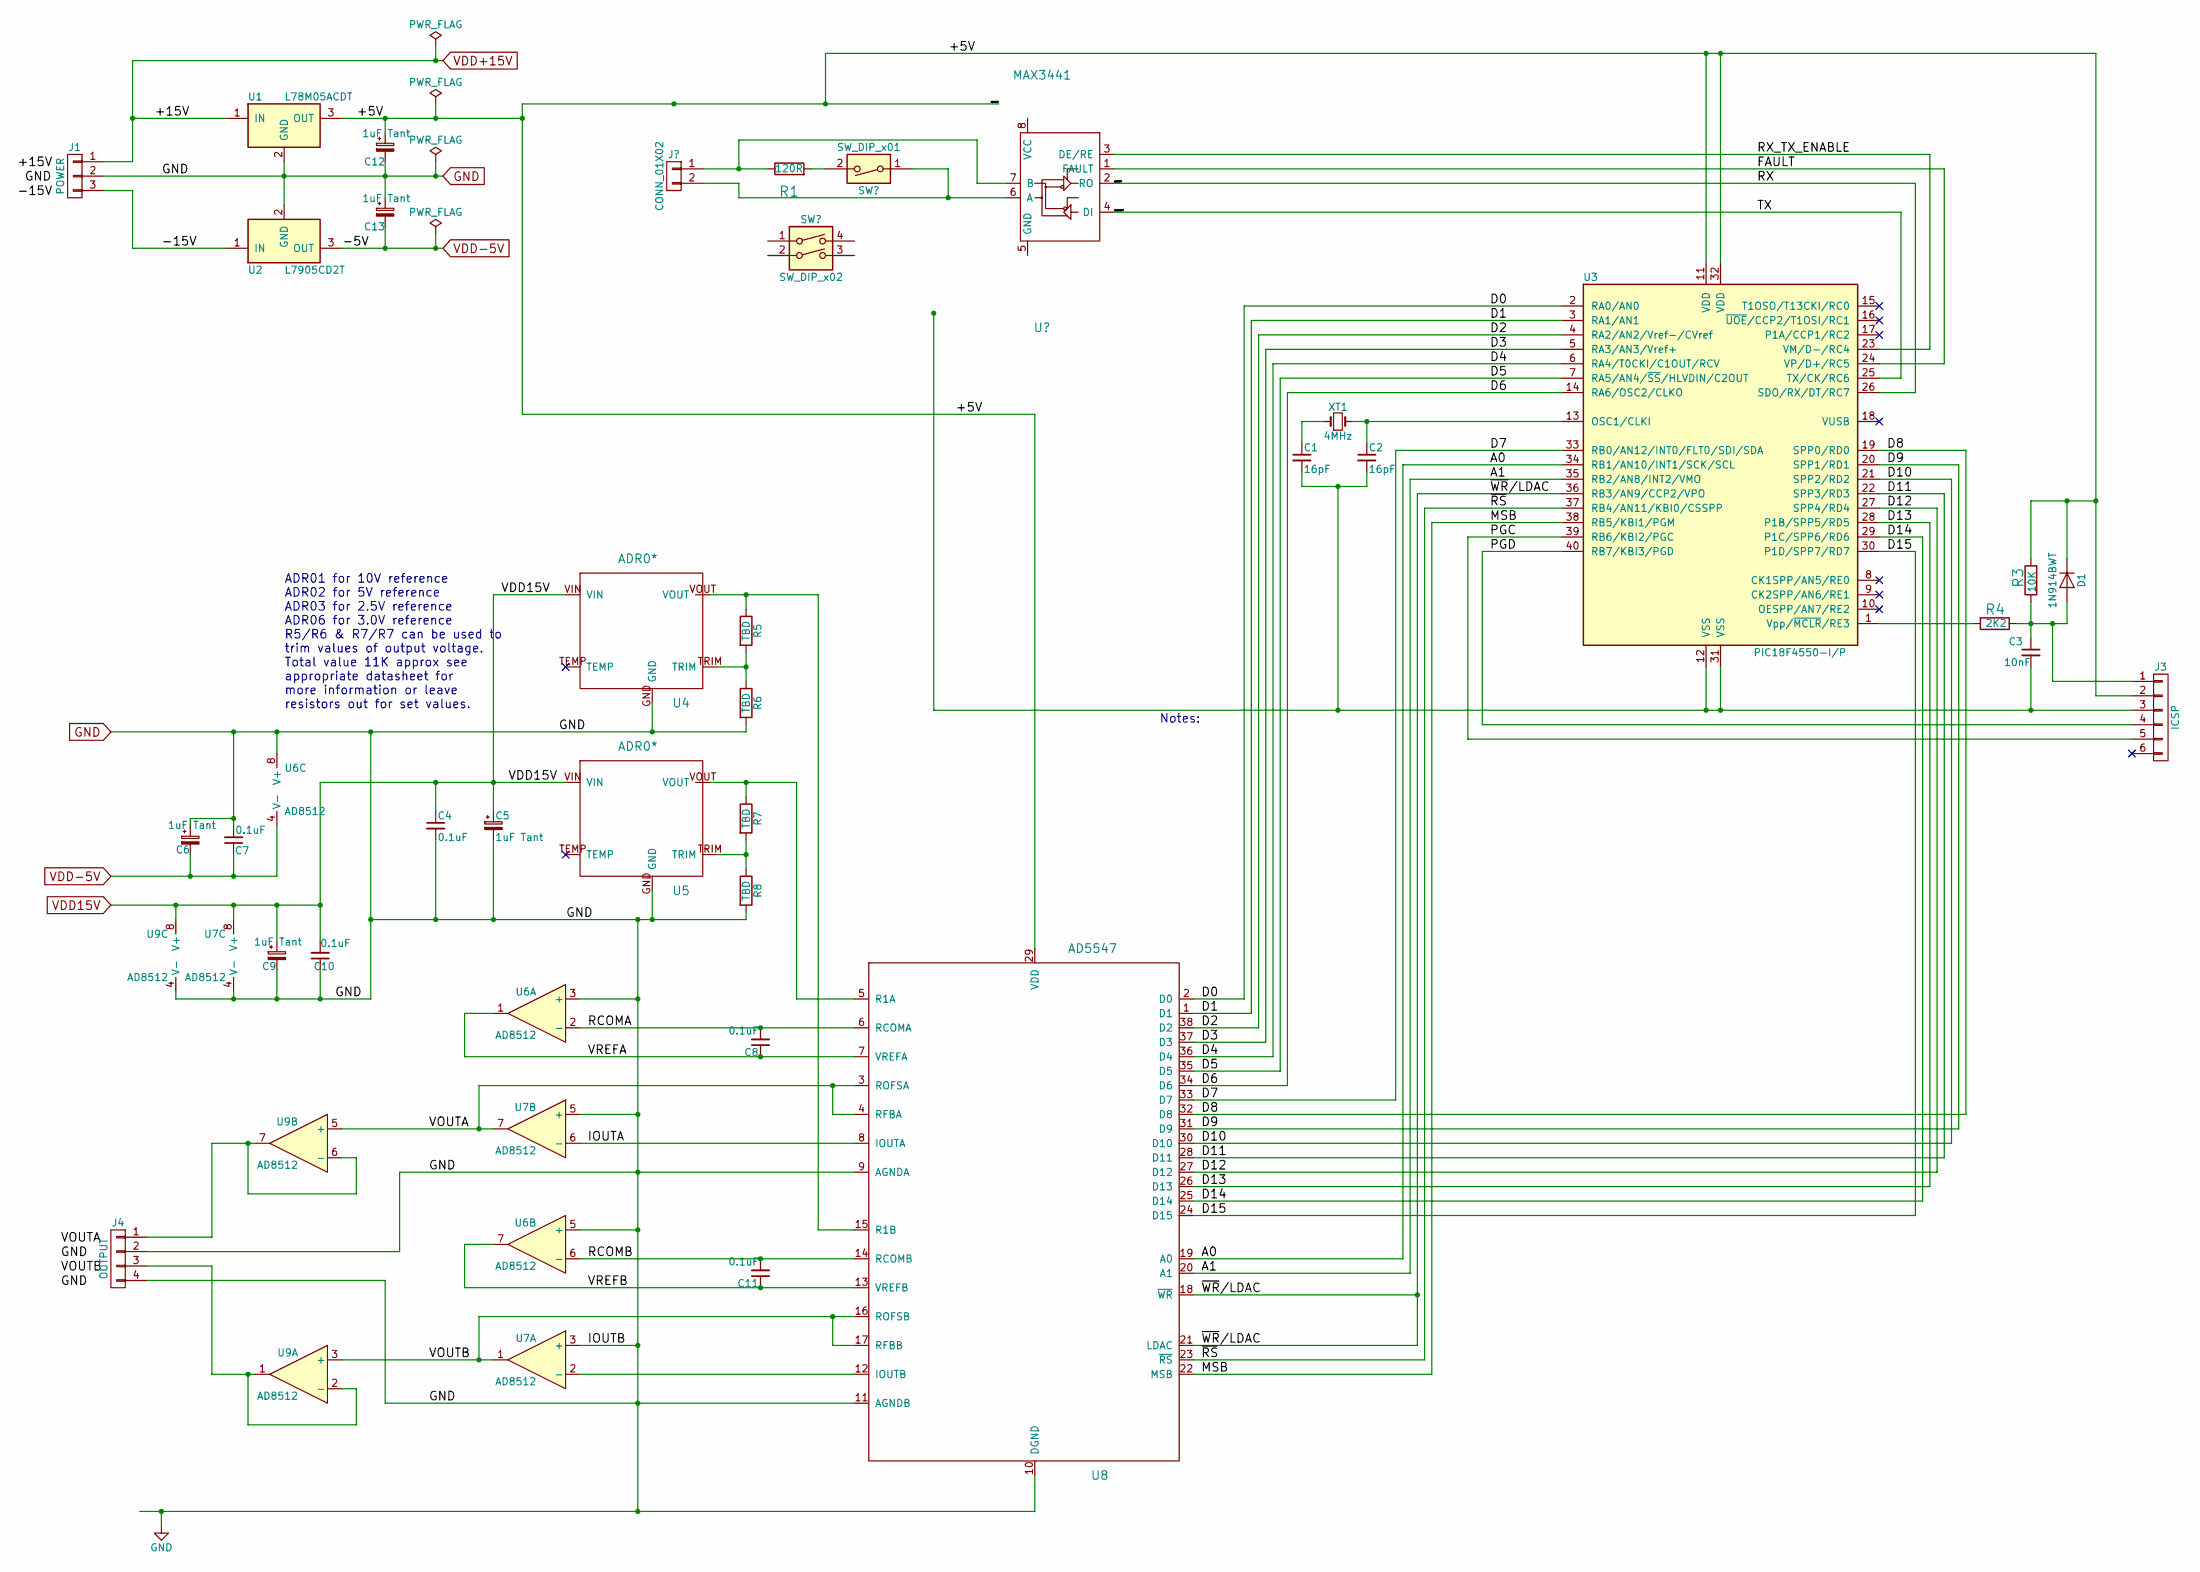
[picture p190: schematic motor_speed_controller.sch, Motor Controller Board]

Parts:
C1, C2: 16pF; C_0805
C3: 10nF; C_0805
C4, C7, C8, C10, C11: 0.1uF; C_0805
C5, C6, C9, C12, C13: 1uF Tant; CP_Tantalum_Case-A_EIA-3216-18_Reflow
D1: 1N914BWT; D_SOD-523F
J1: POWER; CTBP9558_3AO
J3: ICSP; Molex_KK_6373-06_06x2.54mm_Straight
J4: OUTPUT; CTBP9558_4AO
R1: 120R; R_0805
R3: 10K; R_0805
R4: 2K2; R_0805
R5, R6, R7, R8: TBD; R_0805
U1: L78M05ACDT; TO-252-2Lead_L778M05ACDT
U2: L7905CD2T; TO-252-2Lead_L7905CD2T
U3: PIC18F4550-I/P; DIP-40_W15.24mm
U4, U5: ADR0*; TSOT-5-ADR0*
U6, U7: AD8512; SOIC-8-N
U8: AD5547; TSSOP38
U9: AD8512
XT1: 4MHz; Crystal_IQD_HC49-4HSMX

Connections:
/+5V: C12.1, D1.1 (K), J3.2, R3.2, U1.3 (OUT), U3.11 (VDD), U3.32 (VDD), U8.29 (VDD); also elsewhere on the board
/-15V: J1.3, U2.1 (IN)
/A0: U3.34 (RB1/AN10/INT1/SCK/SCL), U8.19 (A0)
/A1: U3.35 (RB2/AN8/INT2/VMO), U8.20 (A1)
/D0: U3.2 (RA0/AN0), U8.2 (D0)
/D1: U3.3 (RA1/AN1), U8.1 (D1)
/D2: U3.4 (RA2/AN2/Vref-/CVref), U8.38 (D2)
/D3: U3.5 (RA3/AN3/Vref+), U8.37 (D3)
/D4: U3.6 (RA4/T0CKI/C1OUT/RCV), U8.36 (D4)
/D5: U3.7 (RA5/AN4/~SS~/HLVDIN/C2OUT), U8.35 (D5)
/D6: U3.14 (RA6/OSC2/CLKO), U8.34 (D6)
/D7: U3.33 (RB0/AN12/INT0/FLT0/SDI/SDA), U8.33 (D7)
/D8: U3.19 (SPP0/RD0), U8.32 (D8)
/D9: U3.20 (SPP1/RD1), U8.31 (D9)
/D10: U3.21 (SPP2/RD2), U8.30 (D10)
/D11: U3.22 (SPP3/RD3), U8.28 (D11)
/D12: U3.27 (SPP4/RD4), U8.27 (D12)
/D13: U3.28 (P1B/SPP5/RD5), U8.26 (D13)
/D14: U3.29 (P1C/SPP6/RD6), U8.25 (D14)
/D15: U3.30 (P1D/SPP7/RD7), U8.24 (D15)
/DATAIN: U3.26 (SDO/RX/DT/RC7); also elsewhere on the board
/DATAOUT: U3.25 (TX/CK/RC6); also elsewhere on the board
/IOUTA: U7.6 (-), U8.8 (IOUTA)
/MSB: U3.38 (RB5/KBI1/PGM), U8.22 (MSB)
/N$9: R1.2; also elsewhere on the board
/N$16: R1.1; also elsewhere on the board
/PGC: J3.5, U3.39 (RB6/KBI2/PGC)
/PGD: J3.4, U3.40 (RB7/KBI3/PGD)
/RCOMA: C8.2, U6.2 (-), U8.6 (RCOMA)
/RCOMB: C11.2, U6.6 (-), U8.14 (RCOMB)
/RX_ENABLE: U3.24 (VP/D+/RC5); also elsewhere on the board
/TX_ENABLE: U3.23 (VM/D-/RC4); also elsewhere on the board
/VOUTA: J4.1, U7.7, U8.3 (ROFSA), U8.4 (RFBA), U9.5 (+), U9.6 (-), U9.7
/VOUTB: J4.3, U7.1, U8.16 (ROFSB), U8.17 (RFBB), U9.1, U9.2 (-), U9.3 (+)
/VREFA: C8.1, U6.1, U8.7 (VREFA)
/VREFB: C11.1, U6.7, U8.13 (VREFB)
/~RS~: U3.37 (RB4/AN11/KBI0/CSSPP), U8.23 (~RS~)
/~WR~/LDAC: U3.36 (RB3/AN9/CCP2/VPO), U8.18 (~WR~), U8.21 (LDAC)
unnamed: C1.1, XT1.1
unnamed: C2.1, U3.13 (OSC1/CLKI), XT1.2
unnamed: C3.1, D1.2 (A), J3.1, R3.1, R4.1
unnamed: R4.2, U3.1 (Vpp/~MCLR~/RE3)
unnamed: R5.1, U4.VOUT, U8.15 (R1B)
unnamed: R5.2, R6.1, U4.TRIM
unnamed: R7.1, U5.VOUT, U8.5 (R1A)
unnamed: R7.2, R8.1, U5.TRIM
unnamed: U7.2 (-), U8.12 (IOUTB)
VDD15V: C4.1, C5.1, C9.1, C10.2, U4.VIN, U5.VIN, U7.8 (V+), U9.8 (V+)
VDD+15V: J1.1, U1.1 (IN)
VDD-5V: C6.2, C7.1, C13.2, U2.3 (OUT), U6.4 (V-)

Notes on the sheet:
Notes:
ADR01 for 10V reference ADR02 for 5V reference ADR03 for 2.5V reference ADR06 for 3.0V reference R5/R6 & R7/R7 can be used to trim values of output voltage. Total value 11K approx see appropriate datasheet for more information or leave resistors out for set values.

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
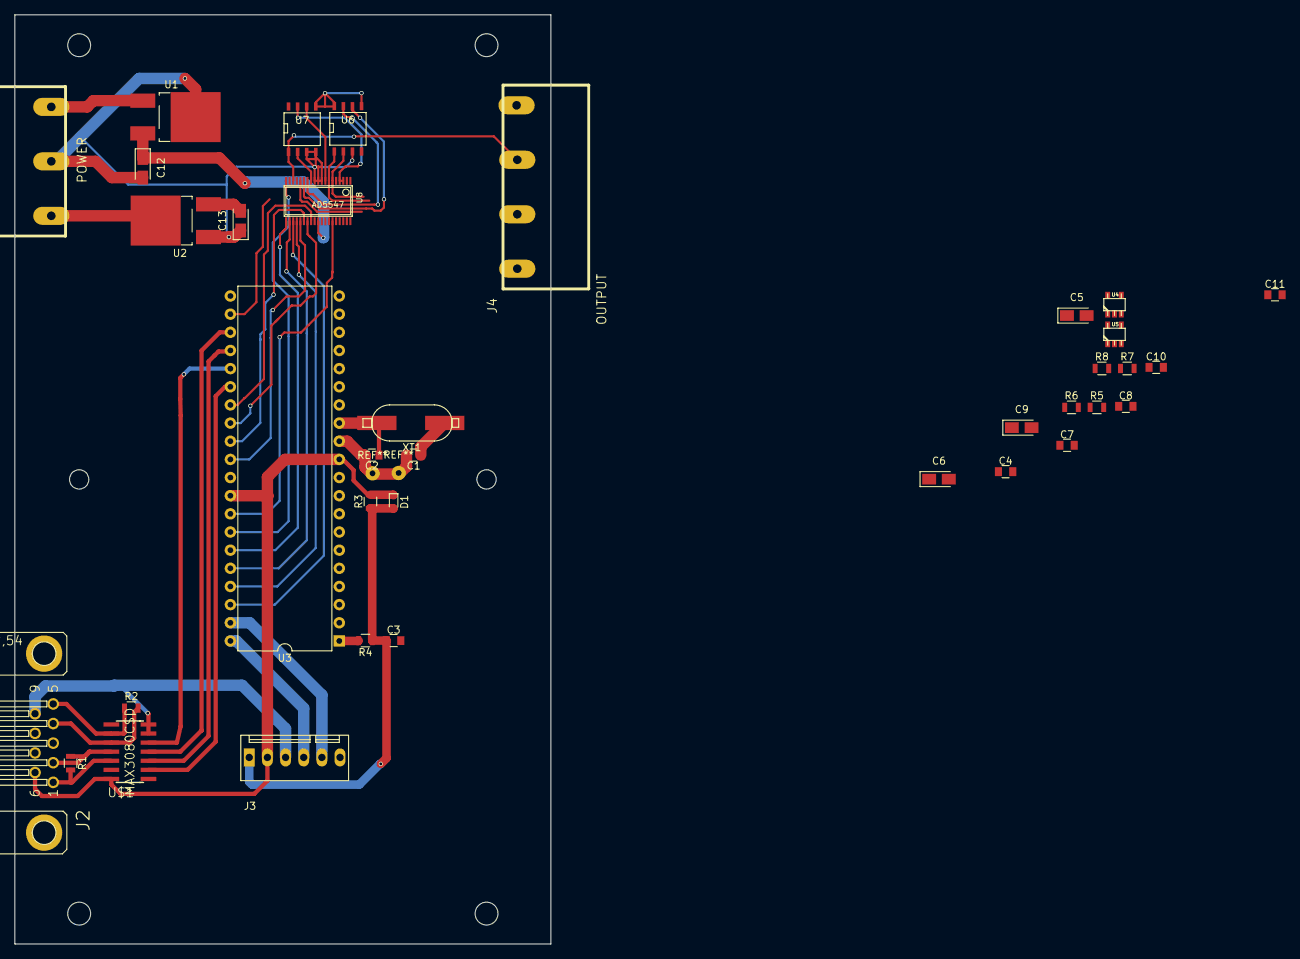
[picture p191: board motor_speed_controller.kicad_pcb from above]

Board: 2 copper layers, 75.0 x 130.0 mm, 36 parts (0 on the bottom side), 53 nets.

Other parts of the board:
J2: RS485; F09HP
R2: 120R; R_0805
U$1: MAX3080CSD; SO14

Their connections:
/+5V: J2.6, U$1.14; also elsewhere on the board
/DATAIN: U$1.2; also elsewhere on the board
/DATAOUT: U$1.5; also elsewhere on the board
/N$9: J2.1, U$1.12; also elsewhere on the board
/N$16: J2.2, U$1.11; also elsewhere on the board
/N$17: J2.4, R2.2, U$1.10
/N$18: J2.5, R2.1, U$1.9
/RX_ENABLE: U$1.3; also elsewhere on the board
/TX_ENABLE: U$1.4; also elsewhere on the board
