simonmeaden/footprints/Harwell/schematics/pcu/lithiumioncharger.kicad_pcb

## KiCad design Harwell/schematics/pcu/lithiumioncharger.kicad_pcb (2017-06-21)

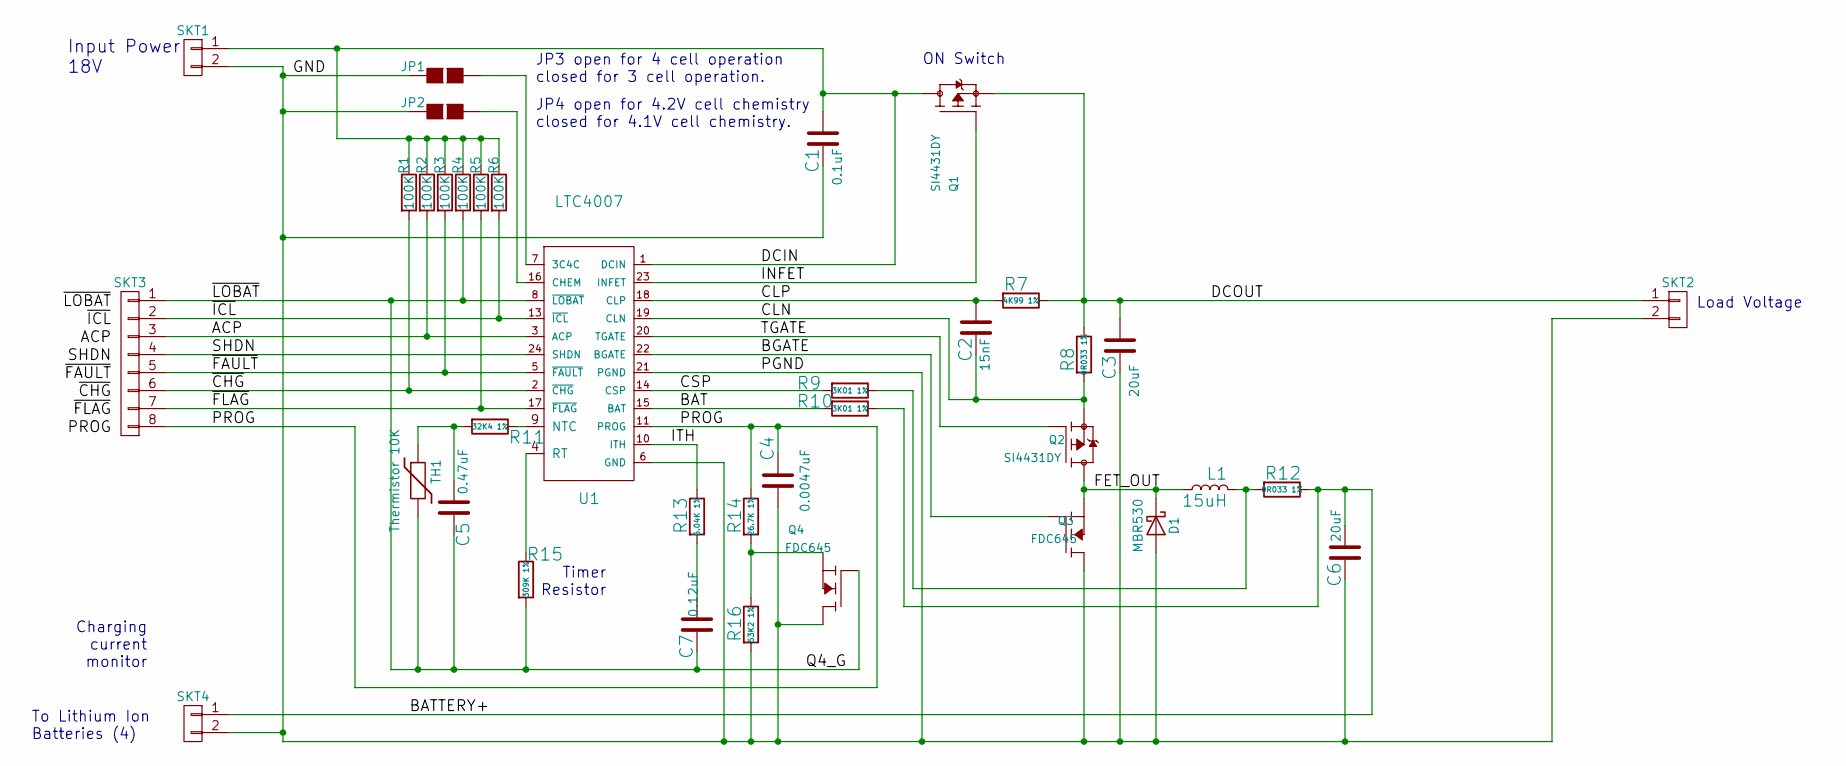
[picture p192: schematic lithiumioncharger.sch, Lithium Ion Charger (3 or 4 cells)]

Parts:
C1: 0.1uF; C_0805
C2: 15nF; C_0805
C3, C6: 20uF; C_0805
C4: 0.0047uF; C_0805
C5: 0.47uF; C_0805
C7: 0.12uF; C_0805
D1: MBR530; D_SOD-123
JP1: Jumper 3; SOLDER-JUMPER_1-WAY
JP2: Jumper 4; SOLDER-JUMPER_1-WAY
L1: 15uH; Inductor_Murata_3900_Series
Q1, Q2: SI4431DY; Si4431CDY
Q3, Q4: FDC645
R1, R2, R3, R4, R5, R6: 100K; R_0805
R7: 4K99 1%; R_0805
R8, R12: 0R033 1%; R_0805
R9, R10: 3K01 1%; R_0805
R11: 32K4 1%; R_0805
R13: 6.04K 1%; R_0805
R14: 26.7K 1%; R_0805
R15: 309K 1%; R_0805
R16: 53K2 1%; R_0805
SKT1, SKT2, SKT4: CONN_01X02; CTBP9558_2AO
SKT3: CONN_01X08; PhoenixContact_MC-G_08x3.81mm_Angled
TH1: Thermistor 10K; R_1206
U1: LTC4007; SSOP-24

Connections:
/ACP: R2.2, SKT3.3, U1.3 (ACP)
/BAT: R10.2, U1.15 (BAT)
/BATTERY+: C6.2, R10.1, R12.1, SKT4.1
/BGATE: Q3.G, U1.22 (BGATE)
/CLN: C2.1, Q2.S, R8.2, U1.19 (CLN)
/CLP: C2.2, R7.2, U1.18 (CLP)
/CSP: R9.2, U1.14 (CSP)
/DCIN: C1.2, Q1.D, R1.1, R2.1, R3.1, R4.1, R5.1, R6.1, SKT1.1, U1.1 (DCIN)
/DCOUT: C3.2, Q1.S, R7.1, R8.1, SKT2.1
/FET_OUT: D1.1 (K), L1.1, Q2.D, Q3.S
/GND: C1.1, C3.1, C4.1, C6.1, D1.2 (A), JP1.2 (G2), JP2.2 (G2), Q3.D, Q4.D, R16.2, SKT1.2, SKT2.2, SKT4.2, U1.6 (GND), U1.21 (PGND)
/INFET: Q1.G, U1.23 (INFET)
/ITH: R13.1, U1.10 (ITH)
/PROG: C4.2, R14.1, SKT3.8, U1.11 (PROG)
/Q4_G: C5.1, C7.1, Q4.G, R4.2, R15.2, SKT3.1, TH1.2, U1.8 (~LOBAT~)
/SHDN: SKT3.4, U1.24 (SHDN)
/TGATE: Q2.G, U1.20 (TGATE)
/~CHG~: R1.2, SKT3.6, U1.2 (~CHG~)
/~FAULT~: R3.2, SKT3.5, U1.5 (~FAULT~)
/~FLAG: R5.2, SKT3.7, U1.17 (~FLAG~)
/~ICL~: R6.2, SKT3.2, U1.13 (~ICL~)
unnamed: C5.2, R11.2, TH1.1
unnamed: C7.2, R13.2
unnamed: JP1.1 (G1), U1.7 (3C4C)
unnamed: JP2.1 (G1), U1.16 (CHEM)
unnamed: L1.2, R9.1, R12.2
unnamed: Q4.S, R14.2, R16.1
unnamed: R11.1, U1.9 (NTC)
unnamed: R15.1, U1.4 (RT)

Notes on the sheet:
To Lithium Ion Batteries (4)
ON Switch
Input Power 18V
Timer Resistor
Charging current monitor
JP3 open for 4 cell operation closed for 3 cell operation.
JP4 open for 4.2V cell chemistry closed for 4.1V cell chemistry.
Load Voltage

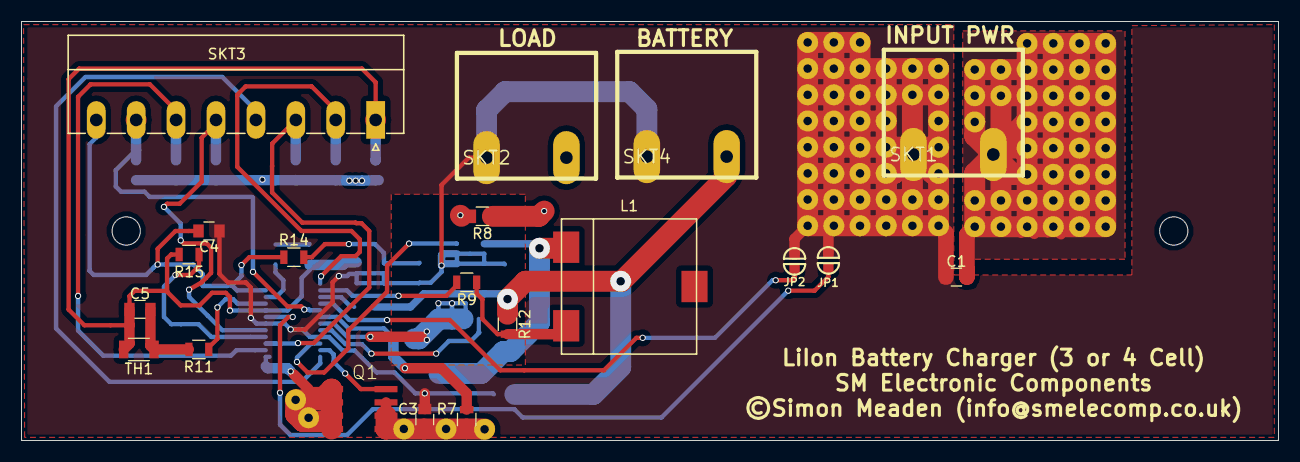
[picture p193: board lithiumioncharger.kicad_pcb from above]

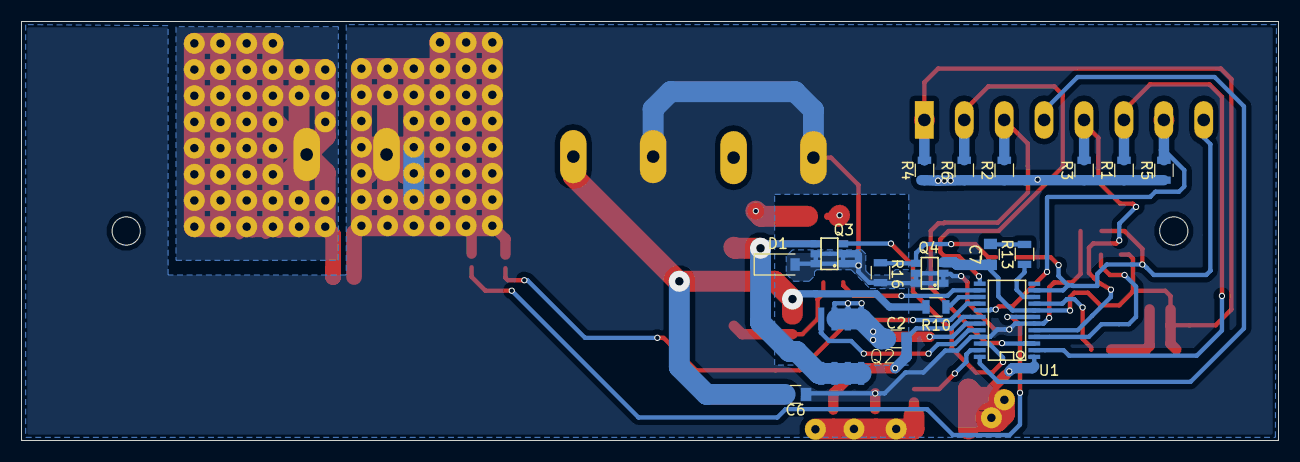
[picture p194: board lithiumioncharger.kicad_pcb from below]

Board: 4 copper layers, 120.0 x 40.0 mm, 37 parts (17 on the bottom side), 29 nets.
