simonmeaden/footprints/Harwell/schematics/pcu/processor_control_unit.kicad_pcb

## KiCad design Harwell/schematics/pcu/processor_control_unit.kicad_pcb (2017-06-21)

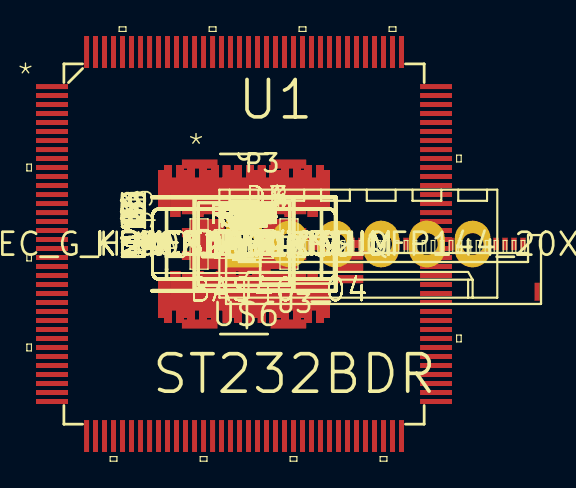
[picture p195: board processor_control_unit.kicad_pcb from above]

Board: 2 copper layers, 219 parts (0 on the bottom side), 166 nets, no tracks yet.

Parts:
C4, C5: 18pF; C_0603
C6, C7, C8, C10, C11, C12, C13, C14: 0.1uF; C_0603
C9: 0.01uF; C_0603
D1, D2, D3, D4, D5: BAS40-04; SOT23
IC1, IC2, IC3, IC4, IC5, IC6, IC7, IC8: MCP23017SS; SSOP28
M1, M2, M3, M4, M5, M6, M7, M8, M9, M10, M11, M12, M13, M14, M15, M16: ACSL-6400; SO16
P1: CONN_01X32; 503480-3200
P3: CONN_01X06; Molex_KK-6410-06_06x2.54mm_Straight
R11, R12: 120R; R_0603
R17, R18, R19, R20, R25, R26, R27, R28, R49, R50, R51, R52, R57, R58, R59, R60, R133, R134, R135, R136, R141, R142, R143, R144, R165, R166, R167, R168, R173, R174, R175, R176, R197, R198, R199, R200, R205, R206, R207, R208, R229, R230, R231, R232, R237, R238, R239, R240, R261, R262, R263, R264, R269, R270, R271, R272, R293, R294, R295, R296, R301, R302, R303, R304: 147R; R_0805
R81, R83, R85, R90, R92, R94, R99, R101, R108, R110, R112, R117, R119, R123, R125, R325, R327, R329, R334, R336, R338, R343, R345, R352, R354, R356, R361, R363, R367, R369: 33K; R_0805
R82, R84, R86, R91, R93, R95, R100, R102, R104, R109, R111, R113, R118, R120, R124, R126, R326, R328, R330, R335, R337, R339, R344, R346, R348, R353, R355, R357, R362, R364, R368, R370: 3K3; R_0805
R87, R88, R89, R96, R97, R98, R105, R106, R107, R114, R115, R116, R121, R122, R127, R128, R331, R332, R333, R340, R341, R342, R349, R350, R351, R358, R359, R360, R365, R366, R371, R372: 10K; R_0805
R103, R347: R33K; R_0805
R129: 10K0; R_0805
R130: 1K0; R_0805
R131, R132: 2K7; R_0805
U1: ST232BDR; SOIC127P600X175-16N
U2, U4: CA3130; SOIC-8-N
U3: MCP47FEB22A0; TSSOP8
U9: PIC32MZXXXXEC_G_H_M_144-I_PLLQFP144_20X20MC-M; LQFP144_20X20MC-M
U$1, U$2, U$3, U$4: KEMET_AMAXIMUM; 3216-18W
U$5: MAX3080CSD; SO14
U$6: 2.2Uh; Inductor_Vishay_IHLP-2020BZ-11_Series

Connections:
/485-RX+: R11.2, U$5.12
/485-RX-: R11.1, U$5.11
/485-TX+: R12.2, U$5.10
/485-TX-: R12.1, U$5.9
/Analogue Inputs/AD0: D1.3, U9.36
/Analogue Inputs/AD1: D2.3, U9.35
/Analogue Inputs/AD2: D3.3, U9.34
/Analogue Inputs/AD3: D4.3, U9.31
/Analogue Inputs/AD4: D5.3, U9.26
/Dual DAC/LATCH/HVC: U3.6, U9.1
/INT-1: IC3.19, IC3.20, U9.79
/INT-2: IC5.19, IC5.20, U9.80
/INT-3: IC6.19, IC6.20, U9.106
/INT-4: IC7.19, IC7.20, U9.105
/Opto Isolated Inputs 1/CH0: IC3.21, M1.14
/Opto Isolated Inputs 1/CH1: IC3.22, M1.13
/Opto Isolated Inputs 1/CH2: IC3.23, M1.12
/Opto Isolated Inputs 1/CH3: IC3.24, M1.11
/Opto Isolated Inputs 1/CH4: IC3.25, M3.14
/Opto Isolated Inputs 1/CH5: IC3.26, M3.13
/Opto Isolated Inputs 1/CH6: IC3.27, M3.12
/Opto Isolated Inputs 1/CH7: IC3.28, M3.11
/Opto Isolated Inputs 1/CH11: IC3.4, M2.11
/Opto Isolated Inputs 1/CH13: IC3.6, M4.13
/Opto Isolated Inputs 1/CH14: IC3.7, M4.12
/Opto Isolated Inputs 1/CH15: IC3.8, M4.11
/Opto Isolated Inputs 2/CH0: IC5.21, M5.14
/Opto Isolated Inputs 2/CH1: IC5.22, M5.13
/Opto Isolated Inputs 2/CH2: IC5.23, M5.12
/Opto Isolated Inputs 2/CH3: IC5.24, M5.11
/Opto Isolated Inputs 2/CH4: IC5.25, M7.14
/Opto Isolated Inputs 2/CH5: IC5.26, M7.13
/Opto Isolated Inputs 2/CH6: IC5.27, M7.12
/Opto Isolated Inputs 2/CH7: IC5.28, M7.11
/Opto Isolated Inputs 2/CH11: IC5.4, M6.11
/Opto Isolated Inputs 2/CH13: IC5.6, M8.13
/Opto Isolated Inputs 2/CH14: IC5.7, M8.12
/Opto Isolated Inputs 2/CH15: IC5.8, M8.11
/Opto Isolated Inputs 3/CH0: IC6.21, M9.14
/Opto Isolated Inputs 3/CH1: IC6.22, M9.13
/Opto Isolated Inputs 3/CH2: IC6.23, M9.12
/Opto Isolated Inputs 3/CH3: IC6.24, M9.11
/Opto Isolated Inputs 3/CH4: IC6.25, M11.14
/Opto Isolated Inputs 3/CH5: IC6.26, M11.13
/Opto Isolated Inputs 3/CH6: IC6.27, M11.12
/Opto Isolated Inputs 3/CH7: IC6.28, M11.11
/Opto Isolated Inputs 3/CH11: IC6.4, M10.11
/Opto Isolated Inputs 3/CH13: IC6.6, M12.13
/Opto Isolated Inputs 3/CH14: IC6.7, M12.12
/Opto Isolated Inputs 3/CH15: IC6.8, M12.11
/Opto Isolated Inputs 4/CH0: IC7.21, M13.14
/Opto Isolated Inputs 4/CH1: IC7.22, M13.13
/Opto Isolated Inputs 4/CH2: IC7.23, M13.12
/Opto Isolated Inputs 4/CH3: IC7.24, M13.11
/Opto Isolated Inputs 4/CH4: IC7.25, M15.14
/Opto Isolated Inputs 4/CH5: IC7.26, M15.13
/Opto Isolated Inputs 4/CH6: IC7.27, M15.12
/Opto Isolated Inputs 4/CH7: IC7.28, M15.11
/Opto Isolated Inputs 4/CH11: IC7.4, M14.11
/Opto Isolated Inputs 4/CH13: IC7.6, M16.13
/Opto Isolated Inputs 4/CH14: IC7.7, M16.12
/Opto Isolated Inputs 4/CH15: IC7.8, M16.11
/PMD5: U9.3, U9.4
/Processor Control Unit/232-RX: U1.12, U9.16
/Processor Control Unit/232-TX: U1.11, U9.15
/Processor Control Unit/232-~CTS~: U1.9, U9.23
/Processor Control Unit/232-~RTS~: U1.10, U9.14
/Processor Control Unit/485-RX: U9.62, U$5.5
/Processor Control Unit/485-TX: U9.61, U$5.2
/Processor Control Unit/485-~RE~: U9.8, U$5.3
/Processor Control Unit/MCLR: P3.1, R130.2, U9.20
/Processor Control Unit/PGEC: P3.5, U9.37
/Processor Control Unit/PGED: P3.4, U9.38
/SCL-1: IC1.12, IC2.12, IC3.12, IC4.12, IC5.12, IC6.12, IC7.12, IC8.12, R131.1, U3.7, U9.90, U9.96
/SDA-1: IC3.13, R132.1, U9.91, U9.95
/SDA-2: IC1.13, IC2.13, IC4.13, IC5.13, IC6.13, IC7.13, IC8.13, U3.8
/Transistor buffered output 1/T0: IC4.21, R87.1
/Transistor buffered output 1/T1: IC4.22, R96.1
/Transistor buffered output 1/T2: IC4.23, R105.1
/Transistor buffered output 1/T3: IC4.24, R114.1
/Transistor buffered output 1/T4: IC4.25, R121.1
/Transistor buffered output 1/T5: IC4.26, R127.1
/Transistor buffered output 1/T6: IC4.27, R88.1
/Transistor buffered output 1/T7: IC4.28, R97.1
/Transistor buffered output 1/T8: IC4.1, R106.1
/Transistor buffered output 1/T9: IC4.2, R115.1
/Transistor buffered output 1/T10: IC4.3, R122.1
/Transistor buffered output 1/T11: IC4.4, R128.1
/Transistor buffered output 1/T12: IC4.5, R89.1
/Transistor buffered output 1/T13: IC4.6, R98.1
/Transistor buffered output 1/T14: IC4.7, R107.1
/Transistor buffered output 1/T15: IC4.8, R116.1
/Transistor buffered output 2/T0: IC8.21, R331.1
/Transistor buffered output 2/T1: IC8.22, R340.1
/Transistor buffered output 2/T2: IC8.23, R349.1
/Transistor buffered output 2/T3: IC8.24, R358.1
/Transistor buffered output 2/T4: IC8.25, R365.1
/Transistor buffered output 2/T5: IC8.26, R371.1
/Transistor buffered output 2/T6: IC8.27, R332.1
/Transistor buffered output 2/T7: IC8.28, R341.1
/Transistor buffered output 2/T8: IC8.1, R350.1
/Transistor buffered output 2/T9: IC8.2, R359.1
/Transistor buffered output 2/T10: IC8.3, R366.1
/Transistor buffered output 2/T11: IC8.4, R372.1
/Transistor buffered output 2/T12: IC8.5, R333.1
/Transistor buffered output 2/T13: IC8.6, R342.1
/Transistor buffered output 2/T14: IC8.7, R351.1
/Transistor buffered output 2/T15: IC8.8, R360.1
GND: C4.1, C5.1, C6.2, C7.2, C8.1, C9.2, C10.1, C11.2, C12.2, C13.2, C14.2, D4.1, D5.1, IC1.10, IC1.16, IC2.15, IC3.10, IC3.15, IC3.17, IC4.10, IC4.15, IC4.16, IC5.10, IC5.17, IC6.10, IC6.15, IC7.10, IC8.10, M1.9, M1.16, M3.9, M3.16, M4.9, M4.16, M5.9, M5.16, M7.9, M7.16, M8.9, M8.16, M9.9, M9.16, M11.9, M11.16, M12.9, M12.16, M13.9, M13.16, M15.9, M15.16, M16.9, M16.16, P3.3, R25.2, R26.2, R27.2, R28.2, R141.2, R142.2, R143.2, R144.2, R205.2, R206.2, R207.2, R208.2, R269.2, R270.2, R271.2, R272.2, U1.15, U3.5, U9.17, U9.32, U9.42, U9.54, U9.63, U9.75, U9.89, U9.108, U9.123, U9.136, U$5.6, U$5.7
unnamed: C4.2, U9.72
unnamed: C5.2, U9.71
unnamed: C9.1, R129.1, R130.1
unnamed: D1.1, D2.1, D3.1
unnamed: M1.1, R17.1
unnamed: M1.3, R18.1
unnamed: M1.5, R19.1
unnamed: M1.7, R20.1
unnamed: M3.1, R49.1
unnamed: M3.3, R50.1
unnamed: M3.5, R51.1
unnamed: M3.7, R52.1
unnamed: M4.1, R57.1
unnamed: M4.3, R58.1
unnamed: M4.5, R59.1
unnamed: M4.7, R60.1
unnamed: M5.1, R133.1
unnamed: M5.3, R134.1
unnamed: M5.5, R135.1
unnamed: M5.7, R136.1
unnamed: M7.1, R165.1
unnamed: M7.3, R166.1
unnamed: M7.5, R167.1
unnamed: M7.7, R168.1
unnamed: M8.1, R173.1
unnamed: M8.3, R174.1
unnamed: M8.5, R175.1
unnamed: M8.7, R176.1
unnamed: M9.1, R197.1
unnamed: M9.3, R198.1
unnamed: M9.5, R199.1
unnamed: M9.7, R200.1
unnamed: M11.1, R229.1
unnamed: M11.3, R230.1
unnamed: M11.5, R231.1
unnamed: M11.7, R232.1
unnamed: M12.1, R237.1
unnamed: M12.3, R238.1
unnamed: M12.5, R239.1
unnamed: M12.7, R240.1
unnamed: M13.1, R261.1
unnamed: M13.3, R262.1
unnamed: M13.5, R263.1
unnamed: M13.7, R264.1
unnamed: M15.1, R293.1
unnamed: M15.3, R294.1
unnamed: M15.5, R295.1
unnamed: M15.7, R296.1
unnamed: M16.1, R301.1
unnamed: M16.3, R302.1
unnamed: M16.5, R303.1
unnamed: M16.7, R304.1
VDD3.3: C6.1, C7.1, C8.2, C10.2, C11.1, C12.1, C13.1, C14.1, D1.2, D2.2, D4.2, D5.2, M1.10, M1.15, M2.10, M2.15, M3.10, M3.15, M4.10, M4.15, M5.10, M5.15, M6.10, M6.15, M7.10, M7.15, M8.10, M8.15, M9.10, M9.15, M10.10, M10.15, M11.10, M11.15, M12.10, M12.15, M13.10, M13.15, M14.10, M14.15, M15.10, M15.15, M16.10, M16.15, P3.2, R17.2, R18.2, R19.2, R20.2, R49.2, R50.2, R51.2, R52.2, R57.2, R58.2, R59.2, R60.2, R129.2, R133.2, R134.2, R135.2, R136.2, R165.2, R166.2, R167.2, R168.2, R173.2, R174.2, R175.2, R176.2, R197.2, R198.2, R199.2, R200.2, R229.2, R230.2, R231.2, R232.2, R237.2, R238.2, R239.2, R240.2, R261.2, R262.2, R263.2, R264.2, R293.2, R294.2, R295.2, R296.2, R301.2, R302.2, R303.2, R304.2, U9.18, U9.33, U9.55, U9.64, U9.88, U9.107, U9.122, U9.137
VDD5.0: IC1.9, IC1.15, IC1.17, IC2.16, IC2.17, IC3.9, IC3.16, IC3.18, IC4.9, IC4.17, IC4.18, IC5.9, IC5.15, IC5.16, IC5.18, IC6.9, IC6.16, IC6.17, IC6.18, IC7.9, IC7.15, IC7.16, IC7.17, IC7.18, IC8.9, IC8.15, IC8.16, IC8.17, IC8.18, R131.2, R132.2, U1.16, U3.1, U3.2, U$5.14
VDD24.0: R81.1, R82.1, R83.1, R84.1, R85.1, R86.1, R90.1, R91.1, R92.1, R93.1, R94.1, R95.1, R99.1, R100.1, R101.1, R102.1, R103.1, R104.1, R108.1, R109.1, R110.1, R111.1, R112.1, R113.1, R117.1, R118.1, R119.1, R120.1, R123.1, R124.1, R125.1, R126.1, R325.1, R326.1, R327.1, R328.1, R329.1, R330.1, R334.1, R335.1, R336.1, R337.1, R338.1, R339.1, R343.1, R344.1, R345.1, R346.1, R347.1, R348.1, R352.1, R353.1, R354.1, R355.1, R356.1, R357.1, R361.1, R362.1, R363.1, R364.1, R367.1, R368.1, R369.1, R370.1
VDD+12.0: U2.7, U4.7
VDD-12.0: U2.4, U4.4
