simonmeaden/footprints/Harwell/programming/mpu/firmware/src/system_config/default/system_config.h

/*******************************************************************************
  MPLAB Harmony System Configuration Header

  File Name:
    system_config.h

  Summary:
    Build-time configuration header for the system defined by this MPLAB Harmony
    project.

  Description:
    An MPLAB Project may have multiple configurations.  This file defines the
    build-time options for a single configuration.

  Remarks:
    This configuration header must not define any prototypes or data
    definitions (or include any files that do).  It only provides macro
    definitions for build-time configuration options that are not instantiated
    until used by another MPLAB Harmony module or application.

    Created with MPLAB Harmony Version 2.02
*******************************************************************************/

// DOM-IGNORE-BEGIN
/*******************************************************************************
Copyright (c) 2013-2015 released Microchip Technology Inc.  All rights reserved.

Microchip licenses to you the right to use, modify, copy and distribute
Software only when embedded on a Microchip microcontroller or digital signal
controller that is integrated into your product or third party product
(pursuant to the sublicense terms in the accompanying license agreement).

You should refer to the license agreement accompanying this Software for
additional information regarding your rights and obligations.

SOFTWARE AND DOCUMENTATION ARE PROVIDED AS IS WITHOUT WARRANTY OF ANY KIND,
EITHER EXPRESS OR IMPLIED, INCLUDING WITHOUT LIMITATION, ANY WARRANTY OF
MERCHANTABILITY, TITLE, NON-INFRINGEMENT AND FITNESS FOR A PARTICULAR PURPOSE.
IN NO EVENT SHALL MICROCHIP OR ITS LICENSORS BE LIABLE OR OBLIGATED UNDER
CONTRACT, NEGLIGENCE, STRICT LIABILITY, CONTRIBUTION, BREACH OF WARRANTY, OR
OTHER LEGAL EQUITABLE THEORY ANY DIRECT OR INDIRECT DAMAGES OR EXPENSES
INCLUDING BUT NOT LIMITED TO ANY INCIDENTAL, SPECIAL, INDIRECT, PUNITIVE OR
CONSEQUENTIAL DAMAGES, LOST PROFITS OR LOST DATA, COST OF PROCUREMENT OF
SUBSTITUTE GOODS, TECHNOLOGY, SERVICES, OR ANY CLAIMS BY THIRD PARTIES
(INCLUDING BUT NOT LIMITED TO ANY DEFENSE THEREOF), OR OTHER SIMILAR COSTS.
*******************************************************************************/
// DOM-IGNORE-END

#ifndef _SYSTEM_CONFIG_H
#define _SYSTEM_CONFIG_H

// *****************************************************************************
// *****************************************************************************
// Section: Included Files
// *****************************************************************************
// *****************************************************************************
/*  This section Includes other configuration headers necessary to completely
    define this configuration.
*/


// DOM-IGNORE-BEGIN
#ifdef __cplusplus  // Provide C++ Compatibility

extern "C" {

#endif
// DOM-IGNORE-END

// *****************************************************************************
// *****************************************************************************
// Section: System Service Configuration
// *****************************************************************************
// *****************************************************************************
// *****************************************************************************
/* Common System Service Configuration Options
*/
#define SYS_VERSION_STR           "2.02"
#define SYS_VERSION               20200

// *****************************************************************************
/* Clock System Service Configuration Options
*/
#define SYS_CLK_FREQ                        200000000ul
#define SYS_CLK_BUS_PERIPHERAL_1            100000000ul
#define SYS_CLK_BUS_PERIPHERAL_2            100000000ul
#define SYS_CLK_BUS_PERIPHERAL_3            100000000ul
#define SYS_CLK_BUS_PERIPHERAL_4            100000000ul
#define SYS_CLK_BUS_PERIPHERAL_5            100000000ul
#define SYS_CLK_BUS_PERIPHERAL_7            200000000ul
#define SYS_CLK_BUS_PERIPHERAL_8            100000000ul
#define SYS_CLK_CONFIG_PRIMARY_XTAL         24000000ul
#define SYS_CLK_CONFIG_SECONDARY_XTAL       32768ul
#define SYS_CLK_CONFIG_FREQ_ERROR_LIMIT     10
#define SYS_CLK_WAIT_FOR_SWITCH             true
#define SYS_CLK_ON_WAIT                     OSC_ON_WAIT_IDLE 
 
/*** Ports System Service Configuration ***/
#define SYS_PORT_A_ANSEL        0x3F23
#define SYS_PORT_A_TRIS         0xFFFF
#define SYS_PORT_A_LAT          0x0000
#define SYS_PORT_A_ODC          0x0000
#define SYS_PORT_A_CNPU         0x0000
#define SYS_PORT_A_CNPD         0x0000
#define SYS_PORT_A_CNEN         0x0000

#define SYS_PORT_B_ANSEL        0xFFFF
#define SYS_PORT_B_TRIS         0xFFFF
#define SYS_PORT_B_LAT          0x0000
#define SYS_PORT_B_ODC          0x0000
#define SYS_PORT_B_CNPU         0x0000
#define SYS_PORT_B_CNPD         0x0000
#define SYS_PORT_B_CNEN         0x0000

#define SYS_PORT_C_ANSEL        0x9FFF
#define SYS_PORT_C_TRIS         0xFFFF
#define SYS_PORT_C_LAT          0x0000
#define SYS_PORT_C_ODC          0x0000
#define SYS_PORT_C_CNPU         0x0000
#define SYS_PORT_C_CNPD         0x0000
#define SYS_PORT_C_CNEN         0x0000

#define SYS_PORT_D_ANSEL        0xC100
#define SYS_PORT_D_TRIS         0xFFFF
#define SYS_PORT_D_LAT          0x0000
#define SYS_PORT_D_ODC          0x0000
#define SYS_PORT_D_CNPU         0x0000
#define SYS_PORT_D_CNPD         0x0000
#define SYS_PORT_D_CNEN         0x0001

#define SYS_PORT_E_ANSEL        0xFFF0
#define SYS_PORT_E_TRIS         0xFFFF
#define SYS_PORT_E_LAT          0x0000
#define SYS_PORT_E_ODC          0x0000
#define SYS_PORT_E_CNPU         0x0000
#define SYS_PORT_E_CNPD         0x0000
#define SYS_PORT_E_CNEN         0x0000

#define SYS_PORT_F_ANSEL        0xFEC0
#define SYS_PORT_F_TRIS         0xFFFF
#define SYS_PORT_F_LAT          0x0000
#define SYS_PORT_F_ODC          0x0000
#define SYS_PORT_F_CNPU         0x0000
#define SYS_PORT_F_CNPD         0x0000
#define SYS_PORT_F_CNEN         0x0004

#define SYS_PORT_G_ANSEL        0x8FFC
#define SYS_PORT_G_TRIS         0xFFFF
#define SYS_PORT_G_LAT          0x0000
#define SYS_PORT_G_ODC          0x0000
#define SYS_PORT_G_CNPU         0x0000
#define SYS_PORT_G_CNPD         0x0000
#define SYS_PORT_G_CNEN         0x0000

#define SYS_PORT_H_ANSEL        0x0070
#define SYS_PORT_H_TRIS         0xFFFF
#define SYS_PORT_H_LAT          0x0000
#define SYS_PORT_H_ODC          0x0000
#define SYS_PORT_H_CNPU         0x0000
#define SYS_PORT_H_CNPD         0x0000
#define SYS_PORT_H_CNEN         0x0000

#define SYS_PORT_J_ANSEL        0x0B00
#define SYS_PORT_J_TRIS         0xFFFF
#define SYS_PORT_J_LAT          0x0000
#define SYS_PORT_J_ODC          0x0000
#define SYS_PORT_J_CNPU         0x0000
#define SYS_PORT_J_CNPD         0x0000
#define SYS_PORT_J_CNEN         0x0000

#define SYS_PORT_K_ANSEL        0xFF00
#define SYS_PORT_K_TRIS         0xFFFF
#define SYS_PORT_K_LAT          0x0000
#define SYS_PORT_K_ODC          0x0000
#define SYS_PORT_K_CNPU         0x0000
#define SYS_PORT_K_CNPD         0x0000
#define SYS_PORT_K_CNEN         0x0000


/*** Interrupt System Service Configuration ***/
#define SYS_INT                     true

// *****************************************************************************
// *****************************************************************************
// Section: Driver Configuration
// *****************************************************************************
// *****************************************************************************
// *****************************************************************************
/* I2C Driver Configuration Options
*/
#define DRV_I2C_INTERRUPT_MODE                    		false
#define DRV_I2C_CLIENTS_NUMBER                    		1
#define DRV_I2C_INSTANCES_NUMBER                  		1

#define DRV_I2C_PERIPHERAL_ID_IDX0                		I2C_ID_5
#define DRV_I2C_OPERATION_MODE_IDX0               		DRV_I2C_MODE_MASTER
#define DRV_SCL_PORT_IDX0                               PORT_CHANNEL_F
#define DRV_SCL_PIN_POSITION_IDX0                       PORTS_BIT_POS_5
#define DRV_SDA_PORT_IDX0                               PORT_CHANNEL_F
#define DRV_SDA_PIN_POSITION_IDX0                       PORTS_BIT_POS_4
#define DRV_I2C_BIT_BANG_IDX0                           false
#define DRV_I2C_STOP_IN_IDLE_IDX0                       false
#define DRV_I2C_SMBus_SPECIFICATION_IDX0			    false
#define DRV_I2C_BAUD_RATE_IDX0                    		100000
#define DRV_I2C_BRG_CLOCK_IDX0	                  		100000000
#define DRV_I2C_SLEW_RATE_CONTROL_IDX0      			false
#define DRV_I2C_MASTER_INT_SRC_IDX0               		INT_SOURCE_I2C_5_MASTER
#define DRV_I2C_SLAVE_INT_SRC_IDX0                		
#define DRV_I2C_ERR_MZ_INT_SRC_IDX0               		INT_SOURCE_I2C_5_BUS
#define DRV_I2C_POWER_STATE_IDX0                  		SYS_MODULE_POWER_RUN_FULL
#define DRV_I2C_INTERRUPT_MODE                    		false

// *****************************************************************************
/* USART Driver Configuration Options
*/
#define DRV_USART_INTERRUPT_MODE                    true

#define DRV_USART_BYTE_MODEL_SUPPORT                true

#define DRV_USART_READ_WRITE_MODEL_SUPPORT          false

#define DRV_USART_BUFFER_QUEUE_SUPPORT              false

#define DRV_USART_CLIENTS_NUMBER                    1
#define DRV_USART_INSTANCES_NUMBER                  1

#define DRV_USART_PERIPHERAL_ID_IDX0                USART_ID_1
#define DRV_USART_OPER_MODE_IDX0                    DRV_USART_OPERATION_MODE_NORMAL
#define DRV_USART_OPER_MODE_DATA_IDX0               
#define DRV_USART_INIT_FLAG_WAKE_ON_START_IDX0      false
#define DRV_USART_INIT_FLAG_AUTO_BAUD_IDX0          false
#define DRV_USART_INIT_FLAG_STOP_IN_IDLE_IDX0       false
#define DRV_USART_INIT_FLAGS_IDX0                   0
#define DRV_USART_BRG_CLOCK_IDX0                    100000000
#define DRV_USART_BAUD_RATE_IDX0                    115200
#define DRV_USART_LINE_CNTRL_IDX0                   DRV_USART_LINE_CONTROL_8NONE1
#define DRV_USART_HANDSHAKE_MODE_IDX0               DRV_USART_HANDSHAKE_NONE
#define DRV_USART_XMIT_INT_SRC_IDX0                 INT_SOURCE_USART_1_TRANSMIT
#define DRV_USART_RCV_INT_SRC_IDX0                  INT_SOURCE_USART_1_RECEIVE
#define DRV_USART_ERR_INT_SRC_IDX0                  INT_SOURCE_USART_1_ERROR
#define DRV_USART_XMIT_INT_VECTOR_IDX0              INT_VECTOR_UART1_TX
#define DRV_USART_XMIT_INT_PRIORITY_IDX0            INT_PRIORITY_LEVEL2
#define DRV_USART_XMIT_INT_SUB_PRIORITY_IDX0        INT_SUBPRIORITY_LEVEL2
#define DRV_USART_RCV_INT_VECTOR_IDX0               INT_VECTOR_UART1_RX
#define DRV_USART_RCV_INT_PRIORITY_IDX0             INT_PRIORITY_LEVEL2
#define DRV_USART_RCV_INT_SUB_PRIORITY_IDX0         INT_SUBPRIORITY_LEVEL2
#define DRV_USART_ERR_INT_VECTOR_IDX0               INT_VECTOR_UART1_FAULT
#define DRV_USART_ERR_INT_PRIORITY_IDX0             INT_PRIORITY_LEVEL2
#define DRV_USART_ERR_INT_SUB_PRIORITY_IDX0         INT_SUBPRIORITY_LEVEL2


#define DRV_USART_POWER_STATE_IDX0                  SYS_MODULE_POWER_RUN_FULL


// *****************************************************************************
// *****************************************************************************
// Section: Middleware & Other Library Configuration
// *****************************************************************************
// *****************************************************************************



// *****************************************************************************
// *****************************************************************************
// Section: Application Configuration
// *****************************************************************************
// *****************************************************************************
/*** Application Defined Pins ***/


/*** Application Instance 0 Configuration ***/

//DOM-IGNORE-BEGIN
#ifdef __cplusplus
}
#endif
//DOM-IGNORE-END

#endif // _SYSTEM_CONFIG_H
/*******************************************************************************
 End of File
*/
