simonmeaden/footprints/Harwell/programming/mpu/firmware/src/system_config/default/system_init.c

/*******************************************************************************
  System Initialization File

  File Name:
    system_init.c

  Summary:
    This file contains source code necessary to initialize the system.

  Description:
    This file contains source code necessary to initialize the system.  It
    implements the "SYS_Initialize" function, defines the configuration bits, 
    and allocates any necessary global system resources, such as the 
    sysObj structure that contains the object handles to all the MPLAB Harmony 
    module objects in the system.
 *******************************************************************************/

// DOM-IGNORE-BEGIN
/*******************************************************************************
Copyright (c) 2013-2015 released Microchip Technology Inc.  All rights reserved.

Microchip licenses to you the right to use, modify, copy and distribute
Software only when embedded on a Microchip microcontroller or digital signal
controller that is integrated into your product or third party product
(pursuant to the sublicense terms in the accompanying license agreement).

You should refer to the license agreement accompanying this Software for
additional information regarding your rights and obligations.

SOFTWARE AND DOCUMENTATION ARE PROVIDED AS IS WITHOUT WARRANTY OF ANY KIND,
EITHER EXPRESS OR IMPLIED, INCLUDING WITHOUT LIMITATION, ANY WARRANTY OF
MERCHANTABILITY, TITLE, NON-INFRINGEMENT AND FITNESS FOR A PARTICULAR PURPOSE.
IN NO EVENT SHALL MICROCHIP OR ITS LICENSORS BE LIABLE OR OBLIGATED UNDER
CONTRACT, NEGLIGENCE, STRICT LIABILITY, CONTRIBUTION, BREACH OF WARRANTY, OR
OTHER LEGAL EQUITABLE THEORY ANY DIRECT OR INDIRECT DAMAGES OR EXPENSES
INCLUDING BUT NOT LIMITED TO ANY INCIDENTAL, SPECIAL, INDIRECT, PUNITIVE OR
CONSEQUENTIAL DAMAGES, LOST PROFITS OR LOST DATA, COST OF PROCUREMENT OF
SUBSTITUTE GOODS, TECHNOLOGY, SERVICES, OR ANY CLAIMS BY THIRD PARTIES
(INCLUDING BUT NOT LIMITED TO ANY DEFENSE THEREOF), OR OTHER SIMILAR COSTS.
 *******************************************************************************/
// DOM-IGNORE-END

// *****************************************************************************
// *****************************************************************************
// Section: Included Files
// *****************************************************************************
// *****************************************************************************

#include "system_config.h"
#include "system_definitions.h"


// ****************************************************************************
// ****************************************************************************
// Section: Configuration Bits
// ****************************************************************************
// ****************************************************************************
// <editor-fold defaultstate="collapsed" desc="Configuration Bits">

/*** DEVCFG0 ***/

#pragma config DEBUG =      OFF
#pragma config JTAGEN =     OFF
#pragma config ICESEL =     ICS_PGx1
#pragma config TRCEN =      OFF
#pragma config BOOTISA =    MIPS32
#pragma config FECCCON =    OFF_UNLOCKED
#pragma config FSLEEP =     OFF
#pragma config DBGPER =     PG_ALL
#pragma config SMCLR =      MCLR_NORM
#pragma config SOSCGAIN =   GAIN_LEVEL_3
#pragma config SOSCBOOST =  ON
#pragma config POSCGAIN =   GAIN_LEVEL_3
#pragma config POSCBOOST =  ON
#pragma config EJTAGBEN =   NORMAL
#pragma config CP =         OFF

/*** DEVCFG1 ***/

#pragma config FNOSC =      SPLL
#pragma config DMTINTV =    WIN_127_128
#pragma config FSOSCEN =    OFF
#pragma config IESO =       OFF
#pragma config POSCMOD =    OFF
#pragma config OSCIOFNC =   OFF
#pragma config FCKSM =      CSECME
#pragma config WDTPS =      PS1048576
#pragma config WDTSPGM =    STOP
#pragma config FWDTEN =     OFF
#pragma config WINDIS =     NORMAL
#pragma config FWDTWINSZ =  WINSZ_25
#pragma config DMTCNT =     DMT31
#pragma config FDMTEN =     OFF
/*** DEVCFG2 ***/

#pragma config FPLLIDIV =   DIV_1
#pragma config FPLLRNG =    RANGE_5_10_MHZ
#pragma config FPLLICLK =   PLL_FRC
#pragma config FPLLMULT =   MUL_50
#pragma config FPLLODIV =   DIV_2
#pragma config UPLLFSEL =   FREQ_24MHZ
/*** DEVCFG3 ***/

#pragma config USERID =     0xffff
#pragma config FMIIEN =     ON
#pragma config FETHIO =     ON
#pragma config PGL1WAY =    ON
#pragma config PMDL1WAY =   ON
#pragma config IOL1WAY =    ON
#pragma config FUSBIDIO =   ON

/*** BF1SEQ0 ***/

#pragma config TSEQ =       0x0000
#pragma config CSEQ =       0xffff
// </editor-fold>

// *****************************************************************************
// *****************************************************************************
// Section: Driver Initialization Data
// *****************************************************************************
// *****************************************************************************
// <editor-fold defaultstate="collapsed" desc="DRV_I2C Initialization Data">
// *****************************************************************************
/* I2C Driver Initialization Data
*/

const DRV_I2C_INIT drvI2C0InitData =
{
    .i2cId = DRV_I2C_PERIPHERAL_ID_IDX0,
    .i2cMode = DRV_I2C_OPERATION_MODE_IDX0,
    .baudRate = DRV_I2C_BAUD_RATE_IDX0,
    .busspeed = DRV_I2C_SLEW_RATE_CONTROL_IDX0,
    .buslevel = DRV_I2C_SMBus_SPECIFICATION_IDX0,
    .mstrInterruptSource = DRV_I2C_MASTER_INT_SRC_IDX0,
    .errInterruptSource = DRV_I2C_ERR_MZ_INT_SRC_IDX0,

};




// </editor-fold>
// <editor-fold defaultstate="collapsed" desc="DRV_USART Initialization Data">

const DRV_USART_INIT drvUsart0InitData =
{
    .moduleInit.value = DRV_USART_POWER_STATE_IDX0,
    .usartID = DRV_USART_PERIPHERAL_ID_IDX0, 
    .mode = DRV_USART_OPER_MODE_IDX0,
    .flags = DRV_USART_INIT_FLAGS_IDX0,
    .brgClock = DRV_USART_BRG_CLOCK_IDX0,
    .lineControl = DRV_USART_LINE_CNTRL_IDX0,
    .baud = DRV_USART_BAUD_RATE_IDX0,
    .handshake = DRV_USART_HANDSHAKE_MODE_IDX0,
    .interruptTransmit = DRV_USART_XMIT_INT_SRC_IDX0,
    .interruptReceive = DRV_USART_RCV_INT_SRC_IDX0,
    .interruptError = DRV_USART_ERR_INT_SRC_IDX0,
    .dmaChannelTransmit = DMA_CHANNEL_NONE,
    .dmaInterruptTransmit = DRV_USART_XMIT_INT_SRC_IDX0,    
    .dmaChannelReceive = DMA_CHANNEL_NONE,
    .dmaInterruptReceive = DRV_USART_RCV_INT_SRC_IDX0,    
};
// </editor-fold>

// *****************************************************************************
// *****************************************************************************
// Section: System Data
// *****************************************************************************
// *****************************************************************************

/* Structure to hold the object handles for the modules in the system. */
SYSTEM_OBJECTS sysObj;

// *****************************************************************************
// *****************************************************************************
// Section: Module Initialization Data
// *****************************************************************************
// *****************************************************************************

// *****************************************************************************
// *****************************************************************************
// Section: Library/Stack Initialization Data
// *****************************************************************************
// *****************************************************************************

// *****************************************************************************
// *****************************************************************************
// Section: System Initialization
// *****************************************************************************
// *****************************************************************************

/*******************************************************************************
  Function:
    void SYS_Initialize ( void *data )

  Summary:
    Initializes the board, services, drivers, application and other modules.

  Remarks:
    See prototype in system/common/sys_module.h.
 */

void SYS_Initialize ( void* data )
{
    /* Core Processor Initialization */
    SYS_CLK_Initialize( NULL );
    SYS_DEVCON_Initialize(SYS_DEVCON_INDEX_0, (SYS_MODULE_INIT*)NULL);
    SYS_DEVCON_PerformanceConfig(SYS_CLK_SystemFrequencyGet());
    SYS_PORTS_Initialize();

    /* Initialize Drivers */
    sysObj.drvI2C0 = DRV_I2C_Initialize(DRV_I2C_INDEX_0, (SYS_MODULE_INIT *)&drvI2C0InitData);

    sysObj.drvUsart0 = DRV_USART_Initialize(DRV_USART_INDEX_0, (SYS_MODULE_INIT *)&drvUsart0InitData);
    SYS_INT_VectorPrioritySet(INT_VECTOR_UART1_TX, INT_PRIORITY_LEVEL2);
    SYS_INT_VectorSubprioritySet(INT_VECTOR_UART1_TX, INT_SUBPRIORITY_LEVEL2);
    SYS_INT_VectorPrioritySet(INT_VECTOR_UART1_RX, INT_PRIORITY_LEVEL2);
    SYS_INT_VectorSubprioritySet(INT_VECTOR_UART1_RX, INT_SUBPRIORITY_LEVEL2);
    SYS_INT_VectorPrioritySet(INT_VECTOR_UART1_FAULT, INT_PRIORITY_LEVEL2);
    SYS_INT_VectorSubprioritySet(INT_VECTOR_UART1_FAULT, INT_SUBPRIORITY_LEVEL2);

    /* Initialize System Services */

    /*** Interrupt Service Initialization Code ***/
    SYS_INT_Initialize();

    /*Setup the INT_SOURCE_EXTERNAL_1 and Enable it*/
    SYS_INT_VectorPrioritySet(INT_VECTOR_INT1, INT_PRIORITY_LEVEL1);
    SYS_INT_VectorSubprioritySet(INT_VECTOR_INT1, INT_SUBPRIORITY_LEVEL1);
    SYS_INT_ExternalInterruptTriggerSet(INT_EXTERNAL_INT_SOURCE1,INT_EDGE_TRIGGER_RISING);
    SYS_INT_SourceEnable(INT_SOURCE_EXTERNAL_1);

    /*Setup the INT_SOURCE_EXTERNAL_2 and Enable it*/
    SYS_INT_VectorPrioritySet(INT_VECTOR_INT2, INT_PRIORITY_LEVEL1);
    SYS_INT_VectorSubprioritySet(INT_VECTOR_INT2, INT_SUBPRIORITY_LEVEL1);
    SYS_INT_ExternalInterruptTriggerSet(INT_EXTERNAL_INT_SOURCE2,INT_EDGE_TRIGGER_RISING);
    SYS_INT_SourceEnable(INT_SOURCE_EXTERNAL_2);

    /*Setup the INT_SOURCE_EXTERNAL_3 and Enable it*/
    SYS_INT_VectorPrioritySet(INT_VECTOR_INT3, INT_PRIORITY_LEVEL1);
    SYS_INT_VectorSubprioritySet(INT_VECTOR_INT3, INT_SUBPRIORITY_LEVEL1);
    SYS_INT_ExternalInterruptTriggerSet(INT_EXTERNAL_INT_SOURCE3,INT_EDGE_TRIGGER_RISING);
    SYS_INT_SourceEnable(INT_SOURCE_EXTERNAL_3);

    /*Setup the INT_SOURCE_EXTERNAL_4 and Enable it*/
    SYS_INT_VectorPrioritySet(INT_VECTOR_INT4, INT_PRIORITY_LEVEL1);
    SYS_INT_VectorSubprioritySet(INT_VECTOR_INT4, INT_SUBPRIORITY_LEVEL1);
    SYS_INT_ExternalInterruptTriggerSet(INT_EXTERNAL_INT_SOURCE4,INT_EDGE_TRIGGER_RISING);
    SYS_INT_SourceEnable(INT_SOURCE_EXTERNAL_4);


  
    /* Initialize Middleware */

    /* Enable Global Interrupts */
    SYS_INT_Enable();

    /* Initialize the Application */
    APP_Initialize();
}


/*******************************************************************************
 End of File
*/
