simonmeaden/footprints/Harwell/programming/mpu/firmware/src/global.h

/* 
 * File:   global.h
 * Author: simon
 *
 * Created on 03 June 2017, 07:49
 */

#ifndef GLOBAL_H
#    define	GLOBAL_H

#    ifdef	__cplusplus
extern "C" {
#    endif


#    define ENABLE_485
    //#define ENABLE_232
    //#define ENABLE_USB
#    define ENABLE_I2C
    //#    define ENABLE_SPI
//#    define ENABLE_CAN

#    ifdef	__cplusplus
}
#    endif

#endif	/* GLOBAL_H */
