simonmeaden/footprints/(notices)

Notices in the files:
Harwell/programming/ssd1963/ssd1963.c:
This program is free software; you can redistribute it and/or modify
it under the terms of the GNU General Public License as published by
the Free Software Foundation; either version 2 of the License, or
(at your option) any later version.
Harwell/schematics/tester/rs232.sch:
Copyright © Simon Meaden
Harwell/schematics/pcu/lithiumioncharger.kicad_pcb:
©Simon Meaden (info@smelecomp.co.uk)
